timex-sinclair-projects/TS-2068-Megabank/README.md

# TS-2068 Megabank

A battery-backed 4 MB RAM board for the Timex Sinclair 2068, built the way
Timex meant memory to grow: as **expansion banks** that can take over any 8K
chunk of the address space. It is a card for the expansion bus, for owners
of the TS-Pico v3.

It gives the 2068:

- **Paged memory:** any 8K page of the 4 MB, mapped into any chunk with two
  `OUT`s, at full memory speed.
- **A RAM disk:** `SAVE "r:name"`, `LOAD "r:name"`, `CAT "r:"` and the rest,
  kept through power-off by a battery.

**Status:** design. Nothing is built yet. Start with the
[specification](docs/spec.md); the board's KiCad project (schematic done,
routed on the TS-Pico v3's form factor, DRC clean, not yet ordered) is in
[hardware/](hardware/README.md).

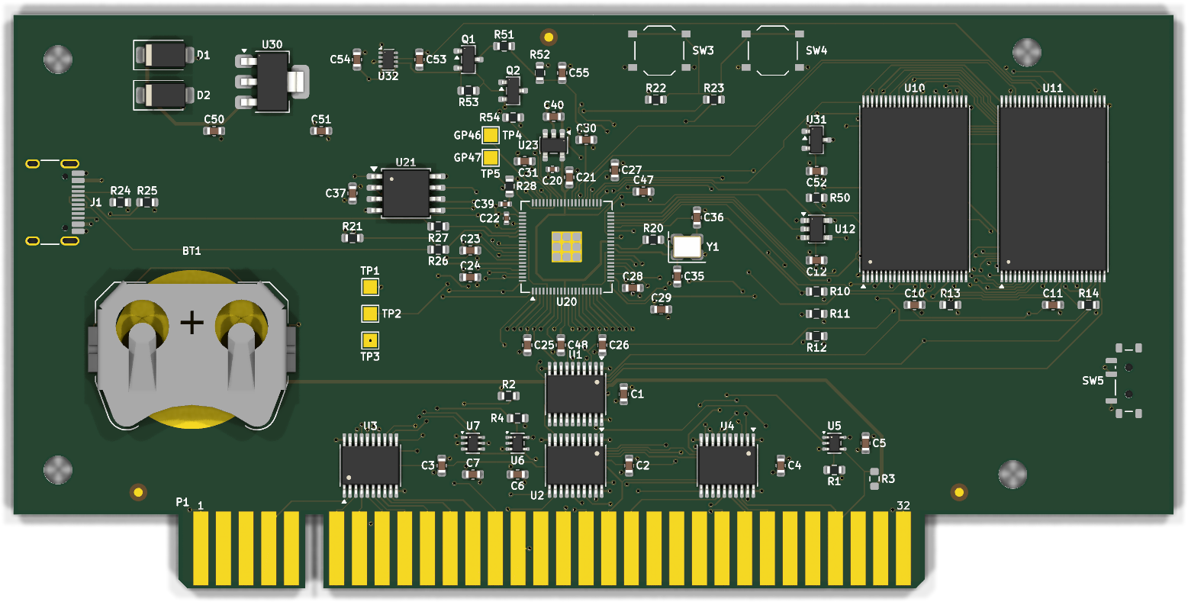
[picture p1: docs/images/megabank-top.png]
The Megabank card, rendered from the routed KiCad board: the RP2350B controller in the middle, the two 2 MB SRAMs on the right, the CR2032 battery on the left, the bus buffers over the gold fingers


*The routed card (KiCad render, 2026-11-07), the same 130 × 64 mm shape as
the TS-Pico v3. Underside: [docs/images/megabank-bottom.png](docs/images/megabank-bottom.png).*

## Where the work lives

| Part | Repository |
|---|---|
| The board: schematic, PCB, the controller's firmware | here |
| The TS-Pico ROM (detection, the RAM disk's copy routine, `r:`, the Timex bank API) and the v3 firmware (bus sharing, the RAM disk's file system) | [tspico-firmware-build](https://github.com/timex-sinclair-projects/tspico-firmware-build) |
| PicoVideo's support (ignoring screen writes to mapped banks) | [PicoVideo](https://github.com/timex-sinclair-projects/PicoVideo) |
| The emulator model | [zesarux-tspico](https://github.com/timex-sinclair-projects/zesarux-tspico) |

## The first test

Does a 2068 answer the board's ports, FCh and FDh? With nothing plugged in:

```
OUT 252,2: OUT 253,2: PRINT IN 252, IN 253
```

The border should not change, and nothing should answer either port.

**Result (2026-10-16), with the TS-Pico fitted:** the border did not change,
and both ports drift between 127 and 255 from one read to the next whatever
keys are held: a floating bus, with nothing answering. FCh and FDh stand.

## Licences

| What | Licence | File |
|---|---|---|
| Hardware design files: schematic and PCB | CERN Open Hardware Licence v2, Permissive (CERN-OHL-P-2.0) | [LICENSE-hardware.txt](LICENSE-hardware.txt) |
| Software: the board's controller firmware (RP2350B), tools and test programs | MIT | [LICENSE](LICENSE) |
| Documentation (`docs/`, this README) | Creative Commons Attribution 4.0 (CC BY 4.0) | [LICENSE-docs.txt](LICENSE-docs.txt) |
