timex-sinclair-projects/TS-2068-Megabank/docs/spec.md

# TS-2068 Megabank (specification, draft)

A battery-backed 4 MB RAM board for the 2068, built the way Timex meant
memory to grow: as **expansion banks** that take over any 8K chunk of the
address space, above HOME, EXROM and DOCK. It is a plain card for a free slot
on the expansion bus, for owners of the TS-Pico v3 card. It gives the 2068
two things it never had:

- **Paged memory.** A program maps any 8K page of the 4 MB into any chunk
  with two `OUT`s and uses it at full memory speed: fonts, icons, window
  buffers, code overlays, a second screen's worth of work space.
- **A RAM disk.** `SAVE "r:name"`, `LOAD "r:name"`, `CAT "r:"` and the rest,
  as fast as the Z80 can copy, kept through power-off by a battery. Later,
  `OPEN #` streams on its files: random-access records from BASIC.

It began with David's question (2026-10-16) whether the TS-Pico could emulate
the LarKen 256K RAMdisk, and with Jon, a 2068 GUI author, asking for a RAM disk.
Decisions taken with David on 2026-10-16 are marked **(decided)**.

**Paths** like `src/tsbus/tsbus.c` or `src/rom/TSPICO-23.ROM` are in the
TS-Pico firmware repository,
[tspico-firmware-build](https://github.com/timex-sinclair-projects/tspico-firmware-build),
where the ROM and v3 firmware changes will be made.

**Status (2026-10-16):** specification only. No hardware, firmware or ROM
change exists yet. Facts quoted from the 2068 ROM are from `src/rom/TSPICO-23.ROM`;
those still to be checked on hardware are listed under [Open questions](#open-questions).

## Contents

- [Background](#background): the LarKen RAMdisk, Timex's expansion banks, and
  why this design follows Timex
- [The board](#the-board): what it does on the bus
- [Registers](#registers): ports FCh/FDh
- [Programming it](#programming-it): for people writing 2068 software
- [ZXDesk](#zxdesk): Jon's port of a GUI desktop, and a storage backend
  for it on the board
- [Hardware](#hardware): the RP2350B controller, parts for JLCPCB
  assembly, battery backup, timing
- [Sharing the bus](#sharing-the-bus): the v3 card, PicoVideo, BUSISO
- [ROM](#rom): what ROM 2.4 adds
- [The RAM disk](#the-ram-disk): `r:`, the mover, the on-board format
- [Channels](#channels-phase-9): `OPEN #n,"r:name"`, streams and records
  on the RAM disk
- [Firmware](#firmware): the v3 card's part
- [PicoVideo](#picovideo)
- [Bus mastering (revision 2)](#bus-mastering-revision-2): what DMA
  into the 2068's RAM would take; not this board
- [Testing](#testing)
- [Phases](#phases)
- [Open questions](#open-questions)
- [Sources](#sources)

## Background

### The LarKen RAMdisk (1980s)

LarKen Electronics' RAMdisk was the 2068's best-known RAM expansion: up to
eight 32K static RAM chips with battery backup, for the LKDOS disk system.

- One chip at a time appears in the **upper 32K of the DOCK bank**: the chip is
  enabled when /MREQ and /ROSCS are low and A15 is high.
- `OUT 7,n` picks the chip. Bits 0–2 select it (in a scrambled order LKDOS
  undoes with a table: 7=A, 3=B, 5=C, 1=D, 6=E, 2=F, 4=G, 0=H), bit 6 enables
  writes. The port is write-only and decoded from A7–A3 = 0 only, so it
  answers all of 00h–07h.
- A 74LS175 latch holds the bits and is cleared at power-up (chip H,
  write-protected). A divider on the 2068's +15 V blocks writes while power
  comes and goes.

We first looked at emulating it on the TS-Pico itself (2026-10-16):

- **v2 can't:** its port decode sees only 0Eh/0Fh, and its dock SRAM is a chip
  the Pico can't read back.
- **v3 could do 128K:** four spare 32K lanes in its image SRAM, switched by
  patching one PIO instruction. But 256K needs the unfitted PSRAM, and the
  result still lives in the DOCK, where it collides with cartridge images
  and ZX48 mode.

A separate board with real battery-backed SRAM is better on every count
**(decided)**. LKDOS compatibility is dropped **(decided)**: this is for v3
owners.

### Timex's expansion banks

The 2068 was designed for far more memory than it shipped with. The Timex
*Third Party Software Guide* (TPSG, section 1) describes it:

- **256 banks of 64K**, each split into eight 8K **chunks** selected by
  A13–A15. Bank 255 is HOME, 254 is EXROM, 0 is DOCK, and **1–253 are
  expansion banks**, the banks Wes Brzozowski called "the missing 253".
- **Each chunk has exactly one owner at a time.** Expansion banks outrank
  DOCK and EXROM, which outrank HOME. HOME owns every chunk nobody else
  claims.
- **An expansion bank takes a chunk by pulling BE low**, which switches off
  all of the 2068's own memory (HOME, EXROM and DOCK selects) for that
  access, whatever ports F4h and FFh say.
- **The bus expansion unit's controller** was to hold, per bank, a
  4-bit-interface "horizontal select" register naming the chunks it owns.
  The TPSG puts its registers on ports FCh (data) and FDh (command). The
  ROM that shipped uses a different, memory-mapped scheme gated by the AY
  chip's IOA5 line (Brzozowski).
- **The ROM carries a bank API** for it: `BANK_ENABLE`, `GOTO_BANK`,
  `CALL_BANK`, `XFER_BYTES`, `GET_BANK_STATUS`, copied at boot from EXROM
  1000h–162Fh to RAM at 6200h (F9C0h in 64-column mode), plus a bank table
  (SYSCON) built by a boot-time search for banks.
- **None of it ever worked.** No bus expansion unit shipped, and Brzozowski
  (*Time Designs*, 1986–87) found the ROM code riddled with bugs: the boot
  search would crash a 2068 that had a real bank. His advice: keep the
  software model, fix the bugs, and replace only the two routines that touch
  hardware (`READ_BS_REG`, `WRITE_BS_REG`). William Pedersen (*Nite-Times
  News*, 1989) proposed the hardware shape used here: an 8-entry table of
  chunk owners, indexed by A13–A15.

### Why follow Timex

**The DOCK-based approach has a wall:** bit 7 of port FFh picks EXROM or DOCK
for every chunk at once. The TS-Pico ROM's own code runs from EXROM in chunks
0–1, so it could never see a DOCK-mapped RAM page at the same time. Expansion
banks sit above both and switch through BE, so:

- the ROM can map RAM into chunk 4 while running from EXROM;
- the DOCK stays free for the v3 card's cartridge images and ZX48 mode;
- the 2068's own documented bank API can be made to work, for the first time.

## The board

**Size: 4 MB (decided)**: 512 pages of 8K, presented as **64 expansion
banks** of 64K (banks 1–64 by default).

**The chunk owner table.** Because a chunk has one owner, the board needs no
register per bank, only one per chunk:

- `OWN0`–`OWN7`: the bank number that owns chunk 0–7, or 0 for none.
- `SUB0`–`SUB7`: which 8K of that bank appears there. Timex's model always
  shows chunk *n* of a bank in chunk *n*, so a write to `OWNn` sets `SUBn` to
  *n*. A program that writes a different `SUBn` afterwards can put **any page
  in any chunk (decided)**.

**On every memory cycle** the board looks up `OWN[A15:A13]`:

1. If the owner is one of the board's banks, and /MREQ is low and /RFSH is high,
   it pulls **/BE** low (open-drain).
2. A read (/RD low) drives D0–D7 from SRAM. An M1 opcode fetch is a read like
   any other, so code runs from the banks.
3. A write (/WR low) stores the byte, unless that chunk is write-protected
   (`WPROT`) or the write-protect switch is on. A refused write is dropped;
   /BE is still pulled, so it doesn't fall through to the 2068's RAM either.
4. Otherwise the board does nothing: no /BE, data bus untouched.

**The SRAM address** is `page × 8K + A12..A0`, with
`page = (owner − BASE) × 8 + SUB[chunk]` (0–511): 22 bits. With two 2 MB
chips the top bit picks the chip; with the four-chip fallback, the top two
([Hardware](#hardware)).

**Reset** (/RESET low): every `OWNn` = 0, `SUBn` = *n*, `WPROT` = 0. The
2068 boots as if the board weren't there. The SRAM keeps its contents.

**Bank numbers.** A setting in the controller's flash sets `BASE`, the first bank: 1, 65,
129 or 193. Two boards can share a 2068 (8 MB), and bank numbers stay inside
Timex's 1–253. With `BASE` = 193 only banks 193–253 (61) are usable.

## Registers

Two ports, decoded from A7–A0 only (A8–A15 ignored, like the v3 card), and
only in a real I/O cycle: /IORQ low with /RD or /WR low, **and /M1 high
(decided)**. An interrupt acknowledge is /M1 with /IORQ, and its address bus
holds the PC, so a decode on /IORQ and A7–A0 alone would take an interrupt at
an address ending FCh or FDh for a port access. Requiring /RD or /WR already
excludes it, as on the v3 card; /M1 is checked as well because it is free (it
is already on GPIO24) and keeps the rule true if the firmware ever acts on
/IORQ before the strobe. **FDh selects a register, FCh reads or writes it
(decided).** These are the
TPSG's BCMDPT and BDATPT. Taking FDh rules out emulating a Spectrum 128's AY
(FFFDh/BFFDh) on the v3 card later; David prefers later Yamaha sound chips
anyway **(decided)**.

| Reg | Name | R/W | Reset | Meaning |
|---|---|---|---|---|
| 00h–07h | `OWN0`–`OWN7` | R/W | 00h | Owner of chunk 0–7: an expansion bank 1–253, or 0 for none. 0, FEh and FFh all mean "none". A write also sets `SUBn` = *n*. |
| 08h–0Fh | `SUB0`–`SUB7` | R/W | *n* | Bits 0–2: the 8K of the owning bank that appears in chunk *n*. Bits 3–7 read 0. |
| 10h | `WPROT` | R/W | 00h | Bit *n* set: writes to chunk *n* are dropped while the board owns it. |
| 11h | `STATUS` | R | – | Bit 0: write-protect switch on. Bit 1: battery low. Other bits 0. |
| 12h | `ID` | R | – | A5h, the signature. |
| 13h | `IDCOMP` | R | – | 5Ah, its complement. With no board the bus floats: reads give 7Fh or FFh, never this pair. |
| 14h | `BASE` | R | – | The first bank number: 1, 65, 129 or 193. |
| 15h | `SIZE` | R | – | Banks fitted: 8, 16, 32 or 64 (a setting in the controller's flash, for boards built with fewer chips). |
| 16h | `VERSION` | R | – | Board/logic version, starting at 1. |

- **IN FDh** reads back the selected register number, so an interrupt handler
  can save and restore it.
- **No auto-increment**, so a device watching the bus (the v3 card, PicoVideo)
  follows the state from the writes alone: the last value written to FDh,
  then the value written to FCh.
- Unused register numbers read FFh and ignore writes.
- **Detecting the board:** `OUT (FDh),12h`, `IN A,(FCh)` gives A5h, then
  `OUT (FDh),13h`, `IN A,(FCh)` gives 5Ah. Anything else: no board. Never
  take a single FFh as "no board": the 2068's bus floats, and D7 often reads 0.

## Programming it

For people writing 2068 software, with or without the ROM's help.

**Map a page.** Put page 2 of bank 5 into chunk 4 (8000h–9FFFh):

```
        di
        ld   a,04h        ; OWN4
        out  (0FDh),a
        ld   a,5          ; bank 5; this also sets SUB4 = 4
        out  (0FCh),a
        ld   a,0Ch        ; SUB4
        out  (0FDh),a
        ld   a,2          ; page 2 of bank 5
        out  (0FCh),a
        ei
```

Unmap it by writing 0 to `OWN4`. For Timex-style use (chunk *n* of the bank in
chunk *n*), the first two `OUT`s are enough.

**Rules.**

- **Don't pull the floor out from under yourself.** Never map over the chunk
  holding the code that's running, or the stack, without moving them first.
- **Interrupts.** A register change is two `OUT`s. If an interrupt handler
  also uses the board, keep `DI` around the pair, or have the handler save
  `IN (FDh)` and restore it.
- **Chunks 0–1 hold the ROM** and the IM 1 handler at 0038h. Mapping RAM there
  is allowed (a 64K-RAM machine), but it is your job to have a handler at 0038h
  or to run with interrupts off or in IM 2.
- **Chunk 3 (or chunk 7 in 64-column mode)** holds the 2068's bank-switching
  code and the machine stack. Timex's rules reserve it. Map over it only if you
  know you don't need either.
- **The screen.** The SCLD draws the picture from its own 16K of RAM
  (4000h–7FFFh), whatever the Z80 sees there. Mapping a bank into chunk 2 or
  3 hides that RAM from the Z80, not from the display: the 2068 keeps showing
  it, and writes go to the bank. So a bank can never be the screen; a frame
  kept in a bank has to be copied into the SCLD's RAM to be seen. Whether
  Z80 accesses to a bank in chunk 2 or 3 are still contended is open
  question 19.
- **The RAM disk's banks** belong to the RAM disk ([below](#the-ram-disk)).
  Ask the ROM for pages rather than picking bank numbers yourself.

**Speed.** `LDIR` moves a byte in 21 T-states: about 160 KB a second at the
2068's 3.53 MHz. A 6K screen copies out of a bank in about 40 ms, **plus
contention**: the screen is in the SCLD's 16K (4000h–7FFFh), and every
access there goes through the SCLD, which stretches the Z80's clock while it
fetches the picture. Reads from the bank are uncontended; the writes into
the display file pay. Copy in the border and vertical blank where you can.
For whole-screen updates in the standard mode, copy into the screen not
being shown (4000h or 6000h) and flip with bit 0 of port FFh at the frame
interrupt, keeping its other bits (bit 7 is EXROM/DOCK, bit 6 the frame
interrupt disable): no tearing. ECM uses both halves, so it cannot flip.

## ZXDesk

ZXDesk is a windowed desktop for the Spectrum 48K by
[mindbox77](https://github.com/mindbox77/zxdesk): overlapping windows,
menus, a notepad, a clock, a calendar, settings and a two-pane file manager
(Commander). Jon, the GUI author behind the RAM disk request, has ported it
to the 2068: source at
[jon0x0/ts2068, ZXDesk2068](https://github.com/jon0x0/ts2068/tree/main/ZXDesk2068)
(read at `30c5d64`, 2026-10-29), with its README, roadmap and a TS-Pico
handoff. Its two builds are copied into [examples/](../examples/):

| Build | Loader | Screen | Code | Stack, IM 2 table | Files, buffers, heap |
|---|---|---|---|---|---|
| `zxdesk2068.tap` | `CLEAR 27647`, `RANDOMIZE USR 33280` | 256 × 192 | 6C00h–B542h | BD00h, BE00h | C000h–FEFFh |
| `zxdesk2068-512.tap` | `CLEAR 30719`, `RANDOMIZE USR 36352` | 512 × 192 | 7800h–C046h | C300h, C400h | C600h–FEFFh |

**How it runs.** It takes the machine over: all chunks HOME (F4h = 0),
its own IM 2 handler, no ROM calls, and no return to BASIC. It reads the
keyboard and both joysticks through the 2068's AY (Kempston mouse detection
is disabled in these builds) and beeps through FEh.

**How it stores files.** Through a registry of storage backends, each six
vectors (`StOpen`, `StClose`, `StRead`, `StWrite`, `StDir`, `StDelete`) plus
capability bits (write, persist, random access, directory). The 2068 build
registers one: RAM, four files of 256 bytes, lost at reset. The Spectrum
builds add tape, esxDOS, a printer, and **a Spectrum 128K RAM disk**
(`src/bank.inc`): a directory in one bank and eight files of 8K, paged in
at C000h through port 7FFDh and copied through a 256-byte staging buffer in
the code region.

**With the board fitted, today: no change.** The board starts with nothing
mapped and ZXDesk never touches FCh or FDh. One thing for Jon: the 2068
build still carries the Spectrum 128's AY routine, writing FFFDh and BFFDh.
The board decodes A7–A0 only, so both writes would land on FDh and change
the selected register (harmless: only a write to FCh changes the mapping).
The flag that selects that routine is cleared at start and never set on the
2068, so the beeper is used instead. Better to remove it than rely on that.

### A Megabank storage backend

The board's first use for ZXDesk: a backend, `ST_MEGABANK`, that keeps
files in battery-backed pages. It is the 128K backend with the paging
changed, and the board is a better fit for it than the 128K: an 8K page is
exactly one 128K file, and any page goes into any chunk with `OUT`s the
Z80 makes itself. (Jon's roadmap finds the TS-Pico's DOCK RAM harder to
use: one 64K bank at a time, each 8K only at its own address, and the bank
chosen by a firmware command whose timing is unmeasured.) The work is
Jon's:

1. **The layout.** Until `tpi:ram alloc` exists, use the board's first
   bank, pages 0–7 of the board: page 0 the directory, pages 1–7 seven
   files of 8K. The RAM disk grows down from the top of the board, so the
   bottom bank is the last it reaches. The directory page starts with a
   header: a magic number ("ZXDK"), a format version and the file count.
2. **A window in chunk 7.** For each directory access or transfer, map the
   page at E000h, copy through the staging buffer, and unmap, as the 128K
   backend does at C000h with 7FFDh. Chunk 7 holds only buffers and heap in
   both builds, never the code, the stack or the IM 2 table, and the
   interrupt handler touches nothing there. (Not chunk 6: in the 512-column
   build it holds the end of the code, the stack and the IM 2 table.) The
   rule reserving chunk 7 in 64-column mode
   ([Programming it](#programming-it)) protects the ROM's bank code and
   stack, which ZXDesk doesn't use. As with 7FFDh, a page can't be mapped
   while the caller's buffer is in the chunk it covers; the staging buffer
   is what makes that safe.

   ```
   ; Map page A (0-7) of the board's first bank at E000h.
   ; MbBase holds BASE, read once at start-up.
   MbPage:
           push bc
           ld   c,a
           ld   a,07h        ; OWN7
           out  (0FDh),a
           ld   a,(MbBase)   ; the first bank; this also sets SUB7 = 7
           out  (0FCh),a
           ld   a,0Fh        ; SUB7
           out  (0FDh),a
           ld   a,c          ; the page
           out  (0FCh),a
           pop  bc
           ret

   ; Give chunk 7 back to HOME.
   MbHome:
           ld   a,07h        ; OWN7
           out  (0FDh),a
           xor  a
           out  (0FCh),a
           ret
   ```

   ZXDesk's interrupt handler never touches the board, so the `OUT` pairs
   need no `DI`.
3. **Detect, then register.** At start, check `ID` (12h) for A5h and
   `IDCOMP` (13h) for 5Ah, read `BASE` (14h) into `MbBase`, and register
   the backend only if the board answers. With no board, ZXDesk is as it
   is now.
4. **Format only if the header is missing.** The 128K backend clears its
   directory at every start, since a 128K's RAM holds nothing worth
   keeping at power-on. Here the directory is the point: check the header
   and keep it if it is good. If not (a new board, or a reset in the
   middle of a directory write), ask before formatting.
5. **Read `STATUS` (11h) at start.** Bit 0 set: the write-protect switch is
   on, so register the backend without `STCAP_WRITE`. Bit 1 set: the
   battery is low; say so. Otherwise the capabilities are write, persist
   and directory, with delete.

Larger files need more than pages: the notepad, Commander's copy (one
256-byte chunk today) and the file lists have their own limits, which
Jon's roadmap already plans to lift.

**Testing.** In the emulator model
([zesarux-tspico](https://github.com/timex-sinclair-projects/zesarux-tspico)):
save a note, reset, load ZXDesk again and open it; with the switch on, a
save is refused and the file is unchanged. Jon's automated test runs on his
TSRun emulator, which would need the board's registers and pages modelled.
On the board, the same across a power cycle.

**Later.** More files than one bank holds (pages from `tpi:ram alloc`);
window save-areas and other buffers in pages, which the 512-column build
most needs, having about 6.4K of heap to the 256-column build's 7.9K (Jon's
roadmap puts a RAM disk first); and files exchanged with BASIC as `r:`
files, which needs a machine-code entry to the RAM disk because ZXDesk
doesn't use the ROM (open question 8).

## Hardware

**Built by JLCPCB, surface-mount throughout (decided).** The board is made the
way the v3 card is, and reuses its tools from the
[tspico-hardware](https://github.com/factus10/tspico-hardware) repository:
`scripts/parts.py` (MPN and LCSC number for every part), `scripts/jlc_price.py`
(prices and stock against JLCPCB's catalog) and `scripts/gen_fab.py` (the
upload files). The aim is no hand soldering. The RP2350's core-regulator
inductor, the one part that might have needed it, is gone: an LDO supplies the
core instead ([Parts](#parts)). The CR2032 holder is the Keystone part that
JLCPCB placed on the OpenSpand card; another holder pushed the order to its
Standard PCBA.

**Design flow (decided): v3's script pipeline**, in tspico-hardware's
`hardware/scripts/`, adapted (it hardcodes the name `tspico-v3`, the board
size, the placement table, the plane nets and the pre-routes):

- **Schematic** from Python with `schlib.py`: every pin gets a net label, no
  wires; one `gen_<sheet>.py` per sheet, flat hierarchy with global labels;
  `parts.py` stamps MPN and LCSC fields. The root sheet is written by hand
  first. KiCad 10.
- **Board** rebuilt from scratch each time: `gen_board.py` (outline, the
  JLC04161H-7628 4-layer stackup, holes, fiducials), then `gen_layout.py`
  (netlist via `kicad-cli sch export netlist`, footprints and a placement
  table in code, GND and +3V3 planes on the inner layers).
- **Routing**: `flow.py --jar freerouting-2.4.1.jar` runs placement,
  `preroute.py` (locked hand routes: the RP2350B's regulator pins and core
  supply, crystal and QFN fanout), `autoroute.py` (plane fanout vias, DSN export, Freerouting, SES
  import) and `finish.py` (repairs, DRC), retrying from placement up to three
  times; then `silk.py`. `check.sh` runs ERC and DRC; `gen_fab.py` writes the
  JLCPCB files. Rules: 0.6/0.3 mm vias, 0.127 mm clearance, no tracks on the
  plane layers. Copying v3's RP2350B placement and orientation lets its
  pre-routes carry over.

**3.3 V inside, 5 V bus (decided).** A controller (RP2350B) and 3.3 V SRAM sit
behind 74LVC buffers. LVC inputs accept the 2068's 5 V, and a 3.3 V high is a
valid TTL high for the Z80, as the v3 card already shows. These are v3's parts
and toolchain. There is no CPLD and no WinCUPL.

### The controller

**An RP2350B replaces the CPLD (decided), as the memory map, not the data
path.** It decodes FCh/FDh, holds the registers, and for each memory cycle
gives /BE, the page's address bits and the SRAM enables. The bytes go straight
between the SRAM and the bus through a 74LVC245, so the RP2350B never handles
them in a memory cycle. Being software, it can grow: a write fence (open
question 4), new registers, settings, all through a firmware update.

- **/BE** uses the mechanism the v3 card proved on a 2068 (`serve` in
  `src/tsbus/tsbus.pio`). A PIO program reads A15–A13 and jumps (`out pc, 3`)
  through an 8-entry chunk table that core 1 patches whenever a register
  changes, with /BE side-set on the same instruction, at 250 MHz. Here the
  table is the owner table: a chunk owned by one of the board's banks jumps to
  the path that asserts /BE.
- **The page bits are not time-critical.** On a 3.53 MHz read about 400 ns pass
  between a valid address and the data being needed; the SRAM (45–55 ns) and a
  buffer (about 5 ns) use under 70 of them. Whether the page comes from a second
  PIO table, a DMA-chained lookup or core 1 is settled on the bench (open
  question 2).
- **Register writes** are I/O cycles of over a microsecond. A PIO program
  catches `OUT` to FDh/FCh, as v3's `io_snoop` does (v3 waits on a gated
  /IOWR; here /IORQ, /WR and /M1 arrive separately and the program checks all
  three, [Registers](#registers)), and core 1 updates the
  tables before the next memory read. `IN` from FCh/FDh is answered the way v3's
  `io_drive` answers `IN 0Eh`.
- **Settings** that were switches and jumpers (`BASE`, `SIZE`) live in the
  controller's flash (open question 11).
- **Safe at power-up.** Every controller output that enables something is
  inactive in the RP2350's reset state (external pull-ups, or an inverting
  driver like /BE's), so the board stays off the bus until its firmware runs.
  The ROM's boot-time writes then set it up ([Sharing the bus](#sharing-the-bus)).

**Pins.** The RP2350B has 48 GPIOs; the 30-GPIO RP2350A is too small.

| Signals | Pins |
|---|---|
| A0–A7 (port decode) and A13–A15 (chunk), from the address buffers | 11 |
| D0–D7, on the SRAM side of the data buffer | 8 |
| /MREQ, /IORQ, /RD, /WR, /RFSH, /M1, /RESET, from the control buffer | 7 |
| /BE request | 1 |
| Page bits: 8 to SRAM A13–A20 (the 9th picks the chip, through the /CE1s) | 8 |
| /CE1 of each SRAM, write inhibit, data buffer enable | 4 |
| Write-protect switch | 1 |
| Battery: ADC (GPIO40–47) and BAT_EN | 2 |
| /BE read back, through the control buffer's spare channel | 1 |
| /INT and /NMI in, through a 74LVC2G34; /NMI out, open-drain (open question 16) | 3 |
| **Total** | **46 of 48** |

The data buffer's direction comes from the buffered /RD, not from a pin. The
two spare GPIOs, 46 and 47, go to test pads TP4 and TP5 (silk "GP46",
"GP47"), for bench experiments such as a second controller's handshake
([Bus mastering](#bus-mastering-revision-2)).

### Parts

Candidates, with JLCPCB stock on 2026-10-16. Availability is open question 6.

| Function | Part (candidate) | LCSC | Notes |
|---|---|---|---|
| Memory | 2 × CY62167EV30LL-45ZXIT (16 Mbit, 2.2–3.6 V, 45 ns, TSOP-I 48), used as 2M×8 | C511152 | 4 MB in two chips. **×8 confirmed (decided):** BYTE tied to ground makes it 2M×8, pin 45 (I/O15/A20) becomes A20, and BHE, BLE and I/O8–I/O14 are unused. Preferred over the DV30 for its standby current (below). 42 in stock: thin. |
| Memory (alternate) | 2 × CY62167DV30LL-55ZXIT (same package drawing 51-85183 and pinout) | C2956479 | 168 in stock. The same footprint, with one difference: the DV30 marks BHE and BLE "do not use, leave floating", while the EV30 needs them tied to a logic level for its standby figures. Route each to ground through an unfitted 0 Ω pad: fitted for the EV30, left open for the DV30. Its standby is worse: 22 µA maximum per chip, with every input within 0.2 V of a rail. |
| Memory (fallback) | 4 × IS62WV51216BLL-55TLI (512K×16, 3.3 V, TSOP-II-44) | C11315 | 3,623 in stock. Used as ×8: D0–7 tied to D8–15, /LB from A0 and /UB from A0 through a 74LVC1G04; A1–A12 and the page bits form the word address. A different footprint: choose before layout. **No CS2 in TSOP-II (confirmed):** its only chip select is CS1 (pin 6); CS2 exists only on the 48-ball mini-BGA, and JLCPCB's only BGA in stock is the 1.8 V IS62WV51216ALL. So power-fail protection goes through /LB and /UB instead: both come from gates on the SRAM rail whose other input is a "power not good" line (pulled up to the SRAM rail, pulled low by an N-MOSFET from the supervisor while 3.3 V is good), and a chip with both high is deselected. Four chip selects: 44 of the RP2350B's 48 pins. **Much worse standby:** 4 µA typical but 25 µA maximum per chip (industrial), and 20 µA maximum in data retention (down to 1.2 V), with every input within 0.2 V of a rail. Four chips could draw about 100 µA: about three months on a CR2032, nine on a CR2450. Order of preference: EV30, DV30, then this. |
| Controller | RP2350B (QFN-80), with v3's core circuit (QSPI flash, crystal) and an LDO for the core | C42415655 | 4,873 in stock. Copy v3's RP2350B schematic sheet, but **supply DVDD from a 1.2 V LDO (decided 2026-11-07)**, an ME6211C12M5G-N (SOT-23-5, C236672), as on the [OpenSpand card](https://github.com/timex-sinclair-projects/openspand-smd) (U9), instead of the on-chip switching regulator. The switcher's inductor, L1 on v3 (Abracon AOTA-B201610S3R3-101-T, C42411119), was the scarcest part on the board (4 at JLCPCB on 2026-10-16, 3 in October), the only one approved for the RP235x, and would have needed JLCPCB's pre-order or Global Sourcing, or hand fitting. Per the RP2350 datasheet, section 6.3.7, VREG_LX is left open and VREG_FB goes to ground, while VREG_VIN and VREG_AVDD stay powered (the power-on reset runs from them). A fixed 1.2 V matches v3's firmware, which runs at 250 MHz after `vreg_set_voltage(VREG_VOLTAGE_1_20)` (`src/tsbus/tsbus.c`, tspico-firmware-build); here that call has nothing to do, and the firmware may put the unused regulator in its high-impedance mode to save about 400 µA. The LDO is less efficient (3.3 V in, 1.2 V out: about a third of its input power reaches the core), a few tens of milliwatts on a card powered from the 2068. |
| Buffers | 4 × 74LVC245APW: A0–A7, A8–A15 and the control lines one way; D0–D7 both ways | C6082 | The same part as v3. Their power-off protection (Ioff) means that with the 2068 off they neither drive nor load the SRAM side. |
| /BE driver | 74LVC1G06 (inverting, open-drain) | C7828 | Wire-ORs with v3's 74LVC06. The RP2350's reset state (input, pull-down) leaves /BE released. |
| /NMI driver | 74LVC1G06, a second one | C7828 | The same part, so no second loading fee. Wire-ORs with v3's driver and NMI button; a 10 k pull-down holds it released until the firmware runs, as for /BE. |
| /INT, /NMI in | SN74LVC2G34DCKR (dual buffer, SC-70-6, TI), on 3.3 V | C14461 | 21,890 in stock on 2026-10-19. 5 V-tolerant inputs, as the 74LVC245s. |
| Chip enables | The CY62167's two: /CE1 (active low) and CE2 (active high) | | CE2 low deselects the chip whatever /CE1 does, including in data retention. **Both chips' CE2 come from the supervisor**, with a pull-down to ground, so they are high only while 3.3 V is good. **Each chip's /CE1 comes straight from the controller**, qualified by /MREQ, with a pull-down so it sits at a logic level on battery. No decoder, and no logic on the SRAM rail. |
| /WE gate | SN74LVC1G32DBVR (OR, SOT-23-5, TI), on 3.3 V | C10096 | 139,210 in stock on 2026-10-16. SRAM /WE = buffered /WR OR the controller's write inhibit, which it sets per chunk from `WPROT` and the switch. The write-inhibit line has a **pull-up**, so writes are blocked until the controller's firmware runs: Z80 writes during its boot cannot reach the RAM disk. |
| Power mux | LM66200 (ideal-diode ORing, 1.6–5.5 V, 1.32 µA) | C3235556 | Feeds the SRAM rail from 3.3 V or the battery. **Not the TPS2115A:** it draws about 55 µA from the battery, which would empty a coin cell in months. **Not plain diodes:** with 3.3 V on, the SRAM rail must stay close to 3.3 V, or the buffers and the controller push current into the SRAM's input clamps. |
| Supervisor | TPS3839G33 on 3.3 V (threshold about 3.08 V) | C485802 | Drives both chips' CE2 directly: high while 3.3 V is good, low below the threshold, and the pull-down holds them low with 3.3 V gone. So no writes happen while power rises or falls, well above the SRAM's 2.2 V minimum. Push-pull output, so CE2 needs no pull-up; its output is undefined below 0.6 V, which is what the pull-down covers. Its 200 ms delay keeps the SRAM deselected for 200 ms after power-on: harmless, since nothing maps a bank until software writes the registers. |
| Battery | CR2032 in an SMD holder (a CR2450 clip for longer life) | C22363833, C7498149 | **Keystone 3034TR, C5213768 (decided 2026-11-07),** as on the OpenSpand card, where JLCPCB placed it; 654 in stock. The Q&J CR2032-BS-6-1 (C70377) made JLCPCB move the order to Standard PCBA. If stock runs out, leave it off and fit a 3034 from DigiKey (36-3034-ND) by hand. Two CY62167EV30s in standby (1.5 µA typical, 3.0 µA maximum at 25 °C and 3.5 µA at 40 °C, each) plus the mux (1.3 µA): about 8.5 µA worst case at room temperature, so about three years on a CR2032 and eight on a CR2450. At 85 °C the chips' maximum is 12 µA each. Data is kept down to 1.5 V. Measure the real board. |
| Battery monitor | The RP2350B's ADC, through a switched divider | | [Battery monitor](#battery-monitor). `STATUS` bit 1 below 2.5 V. |
| Switch | Write-protect, SMD slide | | |
| Pull resistors | 6 × 10 k, 0603 (0603WAF1002T5E) | C25804 | JLCPCB basic part, as on v3: no loading fee. **To ground:** CE2 (one, for both chips), each chip's /CE1 (two), the /BE request into the 74LVC1G06 (one, so boot does not rely on the RP2350's internal pull-down and its E9 erratum). **To 3.3 V:** write inhibit (one), the data buffer's /OE (one). 10 k on CE2, not 100 k: CE2 must stay under 0.2 V on battery, and two chips' input leakage (up to about 1 µA each) would put 0.2 V across 100 k; with 3.3 V on, the supervisor still gives at least 2.9 V into it (VDD − 0.4 V at 0.5 mA). The /CE1s are pulled *down*: a pull-up to the SRAM rail would feed the unpowered RP2350B. |
| BHE/BLE links | 2 × 0 Ω, 0603 (0603WAF0000T5E) | C21189 | JLCPCB basic. BHE and BLE to ground: fitted for the EV30, do-not-place for a DV30 build. |

**Standby with the controller off.** CE2 is held low by its pull-down, so the
chips are deselected. The EV30 datasheet allows the other inputs (address, data,
/OE, /WE) to float in standby; only CE1, CE2, BHE, BLE and BYTE must sit at
logic levels, which the pull-downs and the ties to ground give. (The DV30
specifies standby with every input at a rail.)

**From the EV30 datasheet, for layout:** in TSOP-I, input low must not exceed
0.7 V while signals switch (0.8 V static), so keep ground bounce down; and
the chip wants a 100 µs supply ramp and 200 µs before full operation, which
the RP2350B's boot more than covers.

### Battery monitor

The coin cell is measured straight off its terminal, before the LM66200,
through a switch that is off whenever the controller is unpowered or booting,
so the battery never feeds the RP2350B's ADC pin. All parts are JLCPCB basic.

| Net | Connects |
|---|---|
| BATT+ | Battery +, LM66200 IN2, Q1 source, R3 |
| Q1 gate | Q1 gate, R3, Q2 drain |
| Divider top | Q1 drain, R1 |
| ADC | R1, R2, C1, RP2350B ADC pin (one of GPIO40–47) |
| BAT_EN | RP2350B GPIO, Q2 gate, R4 |
| GND | Q2 source, R2, C1, R4 |

| Ref | Part | LCSC | Notes |
|---|---|---|---|
| Q1 | AO3401A, P-channel, SOT-23 | C15127 | Source to the battery. Turns on at about 0.9 V gate drive, so it works down to a 2.0 V cell. Its body diode points at the battery and never conducts, since the drain side is never above it. |
| Q2 | AO3400A, N-channel, SOT-23 | C20917 | Pulls Q1's gate to ground when BAT_EN is high. Threshold at most 1.45 V: margin on a 3.3 V GPIO. |
| R1, R2 | 100 k, 0603 | C25803 | Halves the cell (2.0–3.3 V) to 1.0–1.65 V, clear of the ADC's 3.3 V full scale. 16 µA only while measuring. R2 also holds the ADC pin at 0 V when off. |
| R3 | 1 M, 0603 | C22935 | Holds Q1's gate at the battery: off. |
| R4 | 10 k, 0603 | C25804 | Holds BAT_EN low while the controller is unpowered or booting. The same part as the other pull resistors. |
| C1 | 100 nF, 0603 X7R | C14663 | A low-impedance source for the ADC's sampling capacitor. |

**Off,** the battery's only load here is the two MOSFETs' leakage, well under
a microamp. **To measure,** the controller drives BAT_EN high, waits 25 ms (the
divider and C1 settle with a 5 ms time constant, 50 k × 100 nF), averages a
few ADC readings, and drives BAT_EN low again: battery = 2 × reading ×
3.3 V / 4096. It sets `STATUS` bit 1 below 2.5 V, at boot and perhaps hourly
after. While 3.3 V is present the LM66200 runs from it, so the reading is the
idle cell; a lithium coin cell holds near 3.0 V most of its life and falls
near the end, so 2.5 V is a late warning, not an early one.

### Timing

The 2068's memory cycles leave about 300–400 ns from address to data; 45–55 ns
SRAM through a 5 ns buffer fits with room to spare. The critical path is
**/BE**: it has to switch off the 2068's own memory before that memory drives
the bus. The v3 card does exactly this from the same RP2350 PIO path, and it
works on a 2068. The board's version must still be measured on a 2068 through
the expansion bus, with the v3 card in place (open question 2).

**Refresh.** On a refresh cycle (/RFSH low) the controller stays off the bus
and leaves /BE alone, so it never interferes with the 2068's DRAM refresh.

### Form factor

A standard card for the expansion bus card (TS2068_Extender): three slots and a
pass-through, of which the TS-Pico and PicoVideo normally take two. The board
needs no pass-through of its own. **Gold fingers on the PCB edge (decided)**, using v3's footprint
`TS2068_EdgeConnector_2x32` (generated by `gen_board.py`, measured from the
v2.2 Gerbers): 32 positions at 2.54 mm, 31 fingers a side, the key slot at
position 6, an 83.66 × 8.25 mm tongue with 1 mm corner chamfers; pinout from
the TS2068 Technical Manual (table 2.4.1-1). Order with hard gold if offered
(else ENIG), a 30° bevel, and no copper within 0.3 mm of the slot. v3's
assumption that side A is the top is still unverified: check it before
ordering. **The body is v3's too (2026-10-18):** 130 × 56 mm with the
tongue below, v3's four M3 holes, the RP2350B cluster at v3's coordinates so
its pre-routes carry over. The firmware loads over USB-C, as on v3, with SWD
pads as well (open question 11). The KiCad project, its generators, the GPIO
map and the placement are in [`hardware/`](../hardware/README.md).

## Sharing the bus

Three cards may answer memory cycles: the 2068 itself, the v3 card (HOME and
EXROM with /BE, DOCK without), and this board. Only one answers any access,
and none of it depends on BUSISO or IOA5:

- **The board answers only chunks whose owner is one of its banks.**
- **The v3 card watches the FDh/FCh writes** and stops serving any chunk whose
  owner is 1–253 ([Firmware](#firmware)). Without that, a DOCK chunk would
  have two drivers: /BE switches off the 2068's memory but not the v3 card.
- **/BE is open-drain on both cards**, so they never fight electrically.
- **PicoVideo watches the same writes** and stops copying screen writes into
  its display when chunk 2 or 3 is owned by a bank ([PicoVideo](#picovideo)).
- **The ROM writes every `OWNn` = 0 at boot**, even though the board clears
  them on reset. PicoVideo can't see /RESET and the v3 card keeps its
  shadows through a plain reset, so the boot-time writes resynchronise every
  device that watches.

**BUSISO is not used.** On the TS2068_Extender, a per-slot jumper feeds /BE
to the BUSISO pin of the next-lower slot, so a device there can hold off its
own /BE. The TS-Pico goes in slot 1 with its jumper open (closed, it sees
its own /BE and stops working). This board goes in any free slot, jumper
open, and arbitrates through the owner table instead.

**IOA5 is not used.** It is free on the bus, and the shipped ROM's bank
protocol gated register writes with it. But it is a pin of the AY's port A,
whose direction is bit 6 of AY register 7, the register that also mixes the
tone and noise channels. Sound code commonly writes all of R7, so it would
flip IOA5 under the board's feet; port A also carries the joysticks. Ports
FCh/FDh do the job without that hazard **(decided)**.

## ROM

ROM 2.4 is ROM 2.3 plus patches, built the usual way: `tools/build-rom.py`
byte patches that state the bytes they replace, and new code in the module.
Addresses below are EXROM addresses (X) and, for the bank code that runs from
RAM, the RAM address (RAM = X + 5200h; in 64-column mode the code runs 97C0h
higher). All were read from `src/rom/TSPICO-23.ROM` and compared with the
genuine EXROM (`ROMs/GENUINE-2068-exrom.bin`, the same as ZEsarUX's).

### What ROM 2.3 does with the board

**Nothing, safely.** The boot still runs Timex's bank search (X0A3E–X0DAF). It
probes for banks through the memory-mapped, IOA5-gated registers. A board that
answers only ports FCh/FDh reads as absent, so the bank count stays 0:
`MAXBNK` (5CBEh) and the copy every bank routine reads, at 6315h. Every bank
routine then takes its fast path. A board on a 2068 with ROM 2.3 is invisible
until software writes its registers directly.

**Why the bank count must stay 0 until the bank code is rewritten.** Every
`tpi:` command crosses between HOME and EXROM through `CALL_BANK` and
`GOTO_BANK`, and so does every interrupt that arrives while the EXROM is
mapped (the handler at 62AEh). With a nonzero count:

- each crossing loops over every bank in `SAVE_STATUS`, `BANK_ENABLE` and
  `RESTORE_STATUS`, through the slow memory-mapped register routines (an
  estimated 45 ms per crossing with 64 banks);
- every call that asks for all chunks as HOME (`FF00`, which the TS-Pico's own
  crossings use) first takes every chunk from every expansion bank, so a
  program's mapped pages would vanish behind each ROM call.

So the minimal ROM leaves the count at 0, and the Timex API doesn't know the
board exists. The RAM disk and programs use the registers directly.

### What the ROM needs from SYSCON

SYSCON (5CBCh) points to a table at 5EEAh: the AROS header (8 bytes), the
LROS header at +8 (4 bytes), then 24-byte bank entries from +0Ch, ended by
80h. The boot builds it (EXTINIT X08E7, BLDSCT X09F4) and reads it to start
a cartridge. After the boot, almost every read sits behind a cartridge or a
banked channel:

- **AROS BASIC** (GETAL, AR_LN, AR_NXT, READ, and CLEAR and RUN resetting
  DATADD) tests `ARSFLG` bit 7 first.
- **SELECT** (1265h) and **CLCHAN** (13D8h) read it only for a stream offset
  with bit 7 set ([What `f:` already settled](#what-f-already-settled)).
- **SRCHSC** (1374h) has two callers, the banked OPEN at 1488h and `SAVE *`
  at 24EEh, and nothing reaches either.
- **The bank API** never reads it.

Three reads don't wait for a cartridge. They test SYSCON+1 for 02 (an AROS)
on every 2068:

- **FOR** (1CD1h), when the loop runs zero times and searches for its NEXT;
- **RESTORE** (1EA0h), every time;
- **USR** (388Eh), every call. If SYSCON+1 is 02 and the address is 8000h or
  more, it maps the DOCK chunks named at SYSCON+4 before the call.

These HOME addresses are the same in the genuine ROM and the TS-Pico's. So
for the whole session, not only at boot:

- SYSCON stays 5EEAh, and SYSCON+1 stays 00 unless an AROS is fitted. A
  stray 02 at 5EEBh would make every RESTORE and USR page the DOCK in.
- Nothing of ours (the module, the mover, RAM disk buffers) goes in
  5EEAh–5FFFh. Open question 17 asks whether the TS-Pico plans to.

### Minimal ROM: detection, reset, mover, `r:` (phase 4)

1. **Replace the bank search.** A `JP` at X0A3E to new code frees the old
   search's body, X0A3E–X0DAF: 882 bytes in EXROM chunk 0, which today has
   about 84 bytes free. It is entered two ways, both landing at X0A3E: `CALL 0A3E`
   at X1CA8 (the boot path taken when D is held at power-on, undocumented
   until now) and the fall-through from X09F4, which reads the DOCK's
   LROS/AROS headers on the normal path. The block X0C4C–X0CFA is reachable only
   from HOME 2487h, which nothing calls. (To verify when patching: no other
   entry into the range.) The new code:
   - writes `OWN0`–`OWN7` = 0 and `WPROT` = 0, so every device watching the bus
     starts in step;
   - checks `ID`/`IDCOMP`, reads `BASE`, `SIZE` and `STATUS`;
   - reports them to the TS-Pico (how: open question 3);
   - leaves `MAXBNK` and 6315h at 0;
   - ends as the old code did: `CALL 2082h` (writes SYSCON's 80h end marker).
     The old code also called the renumbering at X0CFB, which does nothing with
     no banks; keep or drop it once checked.
2. **The mover** ([The RAM disk](#the-ram-disk)): the operation loop, the
   window choice and the copy loops, in EXROM chunk 1's free space
   (23D4h–2FFFh, 3116 bytes, and 37B5h–3FFFh, 2123 bytes). Estimated under 512
   bytes.
3. **The `r:` prefix**: a test in `F_HOOK` (`fddcmd.asm` 585) beside the
   `f:` one, a new TPMODE bit (bits 7 and 6 are `tpi:` and `net:`), and the
   tape block routines calling the mover when it is set. `CAT`, `ERASE`,
   `MOVE` and `FORMAT` already reach the firmware as `tpi:` strings, so `r:`
   names need firmware work only.

### The Timex bank API on the board (phase 8)

The owner table makes this much cheaper than Timex's design: the state the
API loops over, one register set per bank, is just 16 bytes on this board
(`OWN0`–`OWN7`, `SUB0`–`SUB7`), whatever the bank count.

1. **Rewrite `WRITE_BS_REG` and `READ_BS_REG`** (RAM 635Ch–6404h, X115C–X1204,
   169 bytes, contiguous) as a translation onto the ports. Keep both entry
   points: their callers and the 64-column fixups (X1D2A, 2C, 2E, 36) use them.
   - A BNA write (register 80h) goes to a RAM latch.
   - An HS write (40h) for bank *b*: `OWNn` = *b* for each bit set; `OWNn` = 0
     where `OWNn` was *b* and the bit is clear.
   - A universal deselect (A0h with BNA 0): `OWNn` = 0 for each bit set.
   - A status read: present (bit 2 = 0) if *b* is within `BASE`…`BASE+SIZE−1`.
   - This also removes a bug: today's `READ_BS_REG` copies the screen byte at
     4000h into 8000h on its way out.
2. **Rewrite `SAVE_STATUS` and `RESTORE_STATUS`** (651Eh/654Ah) to save F4h,
   FFh and the 16 board bytes: constant time instead of a loop per bank.
   `CALL_BANK` reserves (bank count + 2) bytes per frame for this; that size
   changes to match. `RESTORE_STATUS` writes FFh before F4h, which briefly
   maps the DOCK: keep it under `DI`, as the TS-Pico's crossings already are.
3. **Only then** set `MAXBNK` and 6315h to the bank count.
4. **Narrow the TS-Pico's own crossings** from "all chunks to HOME" (`FF00`)
   to chunks 0–1 (`FFFC`, the mask is active-low), so a program's pages in
   chunks 2–7 survive ROM calls. Check each: HOME 3CE3h and 0A50h, HOME 03FCh
   (through 040Dh), EXROM 03DDh, 08DDh, the error path at 0017h–002Dh, and the
   interrupt handler at 62AEh.
5. **Fix the 64-column relocation table.** Four of its 61 entries are wrong
   (X1D34: 64ACh should be 64A9h; X1D38: 650Eh → 650Fh; X1D3A: 6516h → 6517h;
   X1D68: 674Fh → 6744h). In 64-column mode they break `BANK_ENABLE`'s
   expansion-bank paths and all of `XFER_BYTES`. Harmless today, because the
   count is 0. A patch to the EXROM image reaches both copies, since the high one
   is copied from the low.
6. **Brzozowski's patches.** All ten sites still hold the genuine bytes in ROM
   2.3, so every bug is present:

   | RAM | X | Now | New | Fixes |
   |---|---|---|---|---|
   | 649A | 129A | C5 | F3 (DI) | `BANK_ENABLE` not atomic |
   | 651B | 131B | C1 | FB (EI) | same |
   | 66DF | 14DF | 75 | 73 | `MOVE_BYTES` stores HL instead of DE |
   | 66E2 | 14E2 | 74 | 72 | same |
   | 66F3–66F5 | 14F3 | 07 0F 38 | 0B 3C 28 | `CREATE_BITMAP` end byte |
   | 6722 | 1522 | F5 | 00 | `XFER_BYTES`: drop `PUSH AF` |
   | 672B | 152B | 0A | 08 | its parameter offset |
   | 676A | 156A | 47 | 5F | `XFER_BYTES` same-bank mask |
   | 67C2 | 15C2 | 2B | 2C | keep A = 01 on abort |
   | 67FF | 15FF | F1 | 00 | drop `POP AF`; A returns 00 done, 01 aborted |

   Two cautions. His `EI` is unconditional, which would re-enable interrupts
   inside the TS-Pico's own `DI` sections: restore the previous state instead
   (`LD A,I` gives it in P/V). And the `XFER_BYTES` patches change A on return;
   the old bank search relied on it, but the minimal ROM removes that code, and
   the remaining callers (HOME 1899h, 1E0Dh) don't use A.
7. **For the whole API**, also: `GET_STATUS` returns the mask in C for
   expansion banks but in B for the others; `GET_NUMBER` is broken once banks
   exist (its `DJNZ` count is overwritten by `GET_STATUS`, and its EXROM test is
   unreachable); `PUT_WORD`'s `LD D,B` destroys D before storing it; Timex
   Technical Manual fixes 6.5.2–6.5.6.

Items 1–5 make `BANK_ENABLE`, `GOTO_BANK`, `CALL_BANK` and `XFER_BYTES` work
with the board; 6 and 7 complete the API. Which of these to do is open
question 5.

**Two reference gaps** found on the way, for the programmer's reference
whatever happens to this plan: the TS-Pico ROM changes `CALL_BANK` at X1410
(`LD B,(IX+08h)` → `LD B,(IX+09h)`, apparently a fix: the genuine code read
PARAM_IN's low byte twice), and the boot's D-key path at X1C86, which skips the
DOCK header read. Neither is in `docs/reference/rom/`.

## The RAM disk

**The split: the v3 card keeps the file system, the Z80 moves the bytes.**
The TS-Pico can't reach the board's memory, but the Z80 can, at `LDIR`
speed. So:

- **The firmware** (Python, on the v3 card) owns the directory, allocation,
  names, `CAT` output and errors. It is written and host-tested like the rest
  of the firmware, and costs no ROM space.
- **The ROM** runs a small loop, the **mover**, that does what the firmware
  tells it, one operation at a time, over the existing port 0Eh link.
- **The file system's data lives on the board**, so it survives power-off
  with the files. The firmware holds only a cache.

### The mover's operations

The firmware sends an operation; the ROM does it and replies with a status
byte. All lengths are 1–65535; "page:offset" is an 8K page (0–511) and an
offset into it, and a transfer may cross pages.

| Op | Does | Used by |
|---|---|---|
| 1 | Copy *len* bytes of 2068 memory at *addr* to page:offset | SAVE |
| 2 | Copy page:offset to 2068 memory at *addr* | LOAD, MERGE |
| 3 | Compare page:offset with 2068 memory at *addr*; reply with the result | VERIFY |
| 4 | Send page:offset to the TS-Pico through port 0Eh | reading the directory; MOVE from `r:`; backup |
| 5 | Receive bytes from the TS-Pico into page:offset | writing the directory; MOVE to `r:`; restore |
| 6 | Copy page:offset to page:offset (both on the board) | compaction |
| 0 | Done; carries the report code to end the command with (0 = OK) | every command |

**How the mover maps a page.** For each piece of a transfer that lies in one
8K chunk of 2068 memory, it picks a **window chunk** from 4–7 that holds
neither that piece nor the stack. With four candidates and at most two
excluded, one is always free. Then, with interrupts off:

1. Save `OWNw` and `SUBw` (read back through FCh).
2. Map the page: `OWNw` = its bank, `SUBw` = its 8K.
3. `LDIR` (or `CPIR`-style compare, or `INIR`/`OTIR`-style port transfer).
4. Restore `OWNw` and `SUBw`, re-enable interrupts.

The mover runs from EXROM chunks 0–1 and never maps a window there, so it
never unmaps itself. It doesn't depend on the Timex bank API, so the RAM disk
can ship before that API is fixed ([Phases](#phases)).

### From BASIC

| Command | Does |
|---|---|
| `SAVE "r:name" …` | every form `SAVE` takes: `LINE`, `CODE`, `SCREEN$`, `DATA` |
| `LOAD "r:name"`, `VERIFY "r:name"`, `MERGE "r:name"` | as from tape, with the same reports |
| `CAT "r:"` | the directory, with free space |
| `ERASE "r:name"` | delete |
| `MOVE "tpi:name" TO "r:name"`, and back | copy between the SD card and the RAM disk; MOVE copies, as it does today |
| `FORMAT "r:"` | create an empty RAM disk (asks Y/N, as `tpi:` FORMAT does) |
| `SAVE "tpi:ram backup name"` / `"tpi:ram restore name"` | the whole RAM disk to or from an image file on the SD card |
| `SAVE "tpi:ram"` | board found or not, `BASE`, `SIZE`, battery, write-protect switch, RAM disk size and free space |

Names follow the tape rules (up to 10 characters), so a file moves between
tape, SD card and RAM disk unchanged. Because `LOAD "r:name"` goes through
the ROM's own LOAD, a BASIC program, arrays and `SCREEN$` all behave exactly as
they do from tape.

### Where it lives on the board

The RAM disk occupies **the top of the board's banks**, growing down; banks
below it are free for programs. `FORMAT "r:"` asks for a size (default: half
the board).

- **Superblock** in the first 256 bytes of the RAM disk's top page: a magic
  number ("TSRD"), format version, the first and last page of the RAM disk, the
  cluster size, a **generation counter**, and a checksum.
- **Allocation bitmap** and **directory** in the rest of the top page(s).
  A directory entry is 32 bytes: the name, the 17-byte tape header's fields
  (type, length, start, program/array parameters), the first cluster and
  length, flags.
- **Files are contiguous**, in 1K clusters, and files of 8K or more start on a
  page boundary. A program can then map a file's pages directly: `LOAD
  "r:icons"` once, then page the icons in by number. When free space is too
  fragmented for a new file, the firmware compacts the disk with op 6.
- **Caching.** The firmware reads the superblock (op 4, 256 bytes) at the start
  of every `r:` command and re-reads the directory only if the generation
  counter changed. Every change to the directory increments it. That covers
  resets, power cycles and a second TS-Pico.

**Allocating pages for a program**, so programs and files never collide, is
a `tpi:ram alloc` command that reserves pages below the RAM disk and records
them in the superblock. Its exact form is for Jon, the GUI author, to shape (open
question 8).

## Channels (phase 9)

`OPEN #n,"r:name"[,"mode"[,reclen]]` opens a RAM disk file as a stream,
the way `OPEN #n,"f:name"` opens a file on the SD card: then `PRINT #n`,
`INPUT #n`, `INKEY$ #n`, `LIST #n` and `CLOSE #n`. The RAM disk becomes
random-access data storage for BASIC: record files read and written in
place, kept through power-off by the battery. **Proposed, not yet decided.**

The model is the TS-Pico's `f:` channel, which works today. Its references,
in tspico-firmware-build: `docs/reference/flows/channels.md` (the flow end to
end), `docs/reference/rom/exrom-fdd.md` ("The channel driver"),
`docs/reference/rom/home.md` (the three hooks and the HOME stubs at
1488h–14C5h), `docs/reference/firmware/channels.md` (modes, records, TAB).

### What `f:` already settled

These hold for any channel on the 2068, and `r:` keeps every one:

- **The record lives in CHANS.** MAKE-ROOM's POINTERS moves CURCHL, so a
  record above the workspace breaks `INPUT #`; a record in the program loses
  its offset when CHANS grows.
- **Both bytes of the stream's offset stay below 80h.** SELECT (HOME 1230h)
  takes a STRMS entry whose two bytes OR to 80h or more as a banked channel
  and looks it up through SYSCON (1265h). The `f:` OPEN pads each record to
  keep clear of that.
- **Allocations are multiples of 256 bytes**, so closing one moves other
  streams' offsets by their high byte only, and the pads stay right.
- **Records hold fixed HOME addresses** (14A0h, 14A9h), never module
  addresses, so nothing in a record goes stale when the module is rebuilt.
- **Every entry from HOME runs under `DI`** (the bank switch writes FFh then
  F4h; an interrupt between them runs `RST 38h` over the empty DOCK), and
  **inside GUARDED**, so a report raised inside the module restores the bank
  stack through H_TRAP (HOME 14B2h).
- **CURCHL and IY are kept.** A channel routine runs inside someone else's
  `PRINT #`; anything it prints would move the current channel to the screen.
- **CLOSE # takes the record out** and fixes up the others: streams above it
  move down, CURCHL goes to S if it pointed into the record. Stock CLOSE #
  crashes on an unknown letter (its table at 1407h has no terminator), so
  the hook must catch every letter the module creates.

### Question 1: CHANS records or Timex's banked channels

The 2068 ROM has Timex's path for channels whose code lives in an expansion
bank: SELECT's SYSCON lookup, the bank number kept in CRCBN (5CBFh), the
routines called through `CALL_BANK`, and CLCHAN's banked close (13D8h). The
Megabank is made of expansion banks, so it is tempting. **Recommended:
ordinary CHANS records, letter `R`, through the `f:` hooks.** The banked path
loses on every count:

- **It needs phase 8 first.** `CALL_BANK` does nothing useful until the bank
  API works on the board and `MAXBNK` is nonzero.
- **It is slow per character.** Every `RST 10h` would go through `CALL_BANK`
  (parameter frame, `SAVE_STATUS`, `BANK_ENABLE`, `RESTORE_STATUS`), against
  the `f:` stub's one thunk.
- **The code has to live in a bank.** The board is RAM: the driver would be
  copied there at boot from the EXROM, into pages the RAM disk and programs
  also use, and would run from memory any program can overwrite.
- **There is no way in.** The banked OPEN path at HOME 1488h was never
  reachable, and the TS-Pico ROM has rewritten those 55 bytes as its own
  stubs. A new OPEN path would be needed anyway, and the `f:` one exists.
- **SYSCON holds at most 10 entries** (open question 9), and Timex's banked
  path is untested code on a ROM where every other part of the bank API has
  turned out broken.

So `r:` needs **no new HOME bytes**: an `R` record holds the same 14A0h and
14A9h as an `F` record, and the module's `G_OUT`/`G_IN` choose `CH_OUT` or
the `r:` routines by the record's letter (one compare per character). The
changes to the existing driver:

- `CH_OPEN_HOOK` recognises `r:` beside `f:` and `d:`.
- `CH_CLOSE_HOOK` closes `R` records as well as `F` ones; the fix-up of other
  streams moves them by the closed record's own allocation (512 bytes for
  `F`, 256 for `R`) instead of a constant.
- `G_BEEP` skips the key click for `R` records too, so reading is silent.

The banked-channel route stays unused; nothing here depends on open
question 9.

### Question 2: where the bytes go

Two ways to carry a `PRINT #` byte to the board:

- **Through the firmware**, as `f:` does: the ROM buffers 64 bytes, sends
  `tpi:chwr` with the bytes as hex over port 0Eh, and the firmware, which
  can't reach the board, has the mover copy them back from the TS-Pico into
  the page (op 5). Every byte crosses the bus twice, and reading back is the
  `tpi:chrd` data phase at about 75 µs a byte.
- **Straight to the board** from the ROM, through the mover's window: map
  the file's page into a window chunk, store or fetch the byte, restore the
  chunk.

**Recommended: straight to the board, with the firmware involved only at
OPEN, CLOSE and when a file must grow.** The firmware stays the owner of
the file system (names, allocation, the directory); the ROM owns only an
open file's bytes, inside an extent the firmware gave it.

- **Speed.** The window costs about a dozen port accesses (save `OWNw` and
  `SUBw`, map, restore) and the position arithmetic: an estimated 400–500
  T-states per character, about 0.15 ms, on top of the stub, thunk and
  GUARDED cost every `f:` character already pays. No exchange with the
  TS-Pico, no SD card, nothing to wait for. (Estimates; measure in the
  emulator.)
- **No buffers.** Each `PRINT #` byte is on the board when `RST 10h`
  returns, and `INPUT #` reads one byte at a time with no read-ahead. So the
  record is small (256 bytes, mostly pad, against `f:`'s 512), a `u` stream
  needs no rule to stop a read running past a line, and nothing is lost in a
  buffer at NEW or power-off.
- **The window rule** is the mover's: a chunk from 4–7 holding neither the
  stack nor the `R` record (CHANS can reach chunk 4 with many streams open),
  saved and restored, under the `DI` every entry already has. A program's
  own mapped pages survive every `PRINT #`.

**OPEN, CLOSE and growth go to the firmware** through the channel driver's
`CH_SEND`, with the mover running inside the exchange (the firmware may
read or write the directory), ending with op 0's report code:

1. **OPEN** sends the stream, mode, record length, name and `STATUS` (so the
   firmware refuses writing with the write-protect switch on). The firmware
   finds or creates the file and gives it an **extent**: its start on the
   board and the bytes allocated. A file opened for writing gets the free
   run after it as room to grow (trimmed at CLOSE). It writes the stream's
   **slot** on the board (below), and the ROM copies the slot into the
   record.
2. **Growth:** a write past the extent asks for more. The firmware extends
   the file in place, or moves it (op 6) and gives a new extent; no room is
   the RAM disk's full report, with the file intact up to there.
3. **CLOSE** writes the final length and position to the slot, pads an open
   record, and tells the firmware, which writes the length into the
   directory and trims the extent.

### Slots, power-off, NEW and reset

**The open-file slots**: one per stream 0–15, 32 bytes each, in the RAM
disk's top page after the superblock and outside its checksum. A slot names
the directory entry, the extent, the length, the position, the mode and the
record length. The firmware writes it at OPEN; while the stream is open the
ROM keeps the working copy in the record and **writes the length and
position back to the slot at every CR, whenever the position crosses a
256-byte boundary, and at CLOSE** (one window mapping each time). The ROM
reads `STATUS` at each write-back: the switch turned on mid-stream is
reported then, not silently dropped writes.

**Every `r:` command carries an open-stream mask**: a bit for each stream
0–15 whose STRMS entry points at an `R` record. The firmware closes every
slot whose bit is clear: its length goes into the directory and the slot is
freed. That covers, with nothing to clean up by hand:

- **Power-off and reset:** the boot report (open question 3) carries a mask
  of 0, so every slot is closed. A file being written keeps everything up to
  its last CR or 256-byte boundary; the bytes after it are on the board but
  outside the length.
- **NEW,** which empties CHANS and STRMS without the ROM noticing: the next
  `r:` command's mask closes the slots. (`f:` handles NEW by replacing a
  stale entry at the next OPEN of the same stream; the mask is stricter.)
- **A program that clears a STRMS entry by `POKE`.**

The firmware reads the slots with the superblock at the start of each `r:`
command, so `CAT "r:"` shows an open file's current length.

**While a file is open** the firmware never moves it except to grow it for
its own stream, and refuses (Report F, as `f:` documents for a second OPEN
but never enforced): `ERASE` of it, `SAVE` over it, `MOVE` to it, a second
OPEN of it for writing, and `FORMAT "r:"` while any slot is open. Several
streams may read one file. Compaction treats open files as fixed.

### Question 3: modes, records, text

**Modes,** as `f:`: `r` read (the file must exist, else F), `w` write
(created or emptied), `a` append (created if missing, position at the end),
`u` update (created if missing, position 0, read and write), each with an
optional `b`. No mode is `r`. Output to an `r` stream is dropped (INPUT #'s
prompt goes to the stream too); `INPUT #` on `w` or `a` is Q. End of file is
NC NZ from the input routine, which WAIT-KEY turns into **8 End of file**.

**Records,** as `f:`: `OPEN #4,"r:data","u",30` makes a record file (1–254;
otherwise Q).

- `PRINT #4;TAB n;…` and `INPUT #4;TAB n;…` go to record *n*: TAB arrives
  as 23, lo, hi through the output routine, and the ROM computes the
  position, (*n* − 1) × reclen, itself. On a stream file `TAB n` is byte *n*.
- A CR ends the record and isn't stored; a short record is padded (spaces,
  or 0 in binary); a record that would run over its length is Q on the PRINT
  that made it, with nothing written; a record left open by `;` is padded at
  CLOSE; a TAB past the end pads the gap.
- Reading gives one record and a CR. `TAB 0` then a read gives the number of
  records (or bytes); `TAB 0` with data is Q.

Random access is where `r:` is far ahead of `f:`: each `f:` seek and record
is a command to the TS-Pico and an SD card mount, each `r:` one a
multiplication and a window.

**Text and binary.** `f:` translates on the Pico because its files are read
on a PC: keywords spelt out, LF line ends, UTF-8. An `r:` file stays on the
2068, so the ROM keeps its bytes as the 2068 wrote them, with a small
translation in text mode:

- **Text (default), writing:** colour and position controls (16–21 with one
  parameter, 22 with two) are dropped, the comma control (6) becomes spaces
  to the next 16-column stop (the record keeps a column), other controls
  except CR are dropped. Keywords stay single token bytes, so `LIST #4` then
  `INPUT #4;LINE a$` gives the line as the 2068 shows it, and `"a|b"`
  round-trips (unlike `f:`).
- **Text, reading:** LF and CRLF become CR, so a text file MOVEd in from the
  SD card reads line by line; other control bytes are dropped, so `INPUT #`
  never acts on them as editing keys.
- **Binary:** every byte as it is, except that 23 is always TAB (as `f:`).
  `INKEY$ #` is the way to read raw bytes.

Channel files are stored as `CODE` files with start 0, so `LOAD "r:name"
CODE addr` works on them, and any `r:` file (a SAVEd program, a screen) can
be opened `rb` to read its bytes. `MOVE "r:name" TO "tpi:name"` copies the
bytes unchanged: whether it should translate text files to PC text, as an
`f:` file would be, is open question 14.

### Other streams on the RAM disk

- **A listing:** `OPEN #5,"r:"` reads the RAM disk's names, one per
  `INPUT #5`, then 8 End of file; `TAB 0` gives the count. As `d:`, it is
  read-only. The firmware writes the names into a hidden scratch file and
  opens it `r`, so the ROM reads it like any other file.
- **Capturing the printer:** `OPEN #3,"r:listing","w"`, then `LLIST` or
  `LPRINT`, then `CLOSE #3`. Needs checking that `CLOSE #3` puts P back, as
  it should for `f:` (testing).
- **Data that outlives a program:** a file written by one program and read
  by the next after `NEW` or `LOAD`, without the SD card. This is what the
  settings and save games of Jon's GUI need (open question 8).

### Coexisting with `f:`

Both kinds of record sit in CHANS under the same hooks and the same rules,
told apart by the letter. An `F` and an `R` stream can be open together; an
OPEN of a stream already open to either is **O Invalid stream**, as today.
`f:` commands never touch the board, and `r:` characters never talk to the
TS-Pico, so neither slows the other; their OPEN and CLOSE exchanges share
`CH_SEND`'s IDLE wait. The `f:` driver's own code doesn't change beyond the
three points under Question 1.

**ROM space.** The `r:` routines (open and close glue, the output and
input routines with text mode, records and TAB, the slot write-back) are
estimated at 600–900 bytes, in EXROM chunk 1's free space beside the
mover (5,239 bytes free before phase 4).

## Firmware

All on the v3 card; v2 is out of scope **(decided)**.

**Core 1 (C, `tsbus.c`): share the bus.**

1. In the OUT snoop (`tsbus.c` 858–906, beside the F4h/FFh shadow): port FDh
   stores the register number; port FCh, when that number is 00h–07h, stores
   the owner in `sh_own[n]` and resets `sh_sub[n]`. A change rewrites the
   chunk table.
2. `chunk_target` (`tsbus.c` 322) returns `tail` (not ours) for any chunk with
   `sh_own[c]` in 1–253, before looking at F4h and FFh.
3. The DOCK-write path (`tsbus.c` 908) skips owned chunks.
4. `sh_own` clears at power-on and on the card's own reset handling, and is
   resynchronised by the ROM's boot-time writes.

That's a few dozen lines on the existing, proven path: the same mechanism
that already follows F4h and FFh. Owner writes are I/O cycles, which last
over a microsecond, so the table is current before the next memory read.

**Core 0 (Python): the RAM disk.** A new module beside `extcmd.py`:

- the `r:` file system: the format above, allocation, compaction;
- the mover's side of the protocol: sending operations, checking status;
- the `CAT`/`ERASE`/`MOVE`/`FORMAT` handlers for `r:` names;
- `tpi:ram` (info, backup, restore, alloc);
- later (phase 9), the `r:` channels' OPEN, growth and CLOSE, the open-file
  slots and the open-stream mask ([Channels](#channels-phase-9));
- what the ROM reports at boot: board found, `BASE`, `SIZE`, `STATUS`.
  The firmware can't read the board itself, since it can't run bus cycles.

## PicoVideo

PicoVideo (github.com/timex-sinclair-projects/PicoVideo, v4.2) already sees
everything it needs: its GAL passes every I/O cycle to the Pico, and every
memory write to 4000h–7FFFh. It already skips a screen write when port F4h
maps chunk 2 or 3 away from HOME. The change, in `coreB/busMain.c`:

1. Two cases in the I/O-write `switch (gZ80AdrL)`: FDh stores the register
   number; FCh stores the value if that number is 02h or 03h (the owners of
   chunks 2 and 3). PicoVideo needs only whether a bank owns the chunk, not
   which 8K it shows, so it ignores `SUB`.
2. The two memory-write tests skip the write when the chunk's owner is 1–253,
   alongside the existing F4h tests.

About 15 lines. It applies unchanged to an RP2350 re-spin. The boards already
built need only a new UF2. **Without the update,** a PicoVideo shows stray
writes whenever a program maps a bank into chunk 2 or 3; nothing else is
affected.

While there: `case 0xF4:` has no `break` and falls into `case HIRES_ADRL`,
so every `OUT F4h` also overwrites the low byte of the hi-res address. One
line to fix.

**Exploration:** PicoVideo folded into this card as a second RP2350B, with
DVI/HDMI out of its HSTX, the AY in the HDMI audio, and a private path to
the SRAM for Jon's accelerated video:
[picovideo-merge.md](picovideo-merge.md).

## Bus mastering (revision 2)

Not this board. Jon (TS2068 list, 2026-10-20 and 22) proposes REU-style DMA:
the board taking the bus with /BUSRQ and writing frames from the banks
straight into the screen. That is possible through the SCLD's normal path,
not around it: the master has to make memory cycles the SCLD accepts. This
records what it would take, so the decision is there when a revision is.

**What the SCLD needs** (from Load ZX's TC2068 model, `rtl/scld.vhd` and
`rtl/scld_contention.vhd`; the US SCLD to be measured):

- **Z80-shaped cycles on the 2068's clock.** The SCLD latches its DRAM
  address multiplexer on a rising CPU clock edge after /MREQ falls, and makes
  the write strobe from /MREQ, /WR and the address. A master holds /MREQ and
  /WR over the same clock edges as a 3-T Z80 write, and steps on CLK (finger
  B9), since contention works by stopping that clock.
- **/BE released.** The SCLD's write strobe needs /BE high: a master writing
  HOME must not pull it, and the board's own `serve` path, which sees the
  master's cycles on the bus like any others, must be held off meanwhile.
- **The free windows.** The SCLD fetches the picture in the first half of
  each of the 192 picture lines: about 27 µs a line, about 5.3 ms a frame,
  are free, plus about 4.4 ms of border and blanking. About 58% of a frame.
- **Refresh.** The Z80 does no refresh while it has given up the bus, and it
  does not float /RFSH, so a master can't make refresh cycles. Bus holds must
  stay short: a natural pattern is to hold the bus in the free half of each
  picture line and give it back in the fetch half, when the Z80 would be
  contended anyway. A single hold across all of the blanking would pass the
  DRAM's 4 ms.

**What the board would change:**

| What | This board | Revision 2 |
|---|---|---|
| U1/U2, address | Fixed inward, always on | Direction and enable from the controller: in (normal), off (the controller addresses the SRAM privately), out (a master cycle). |
| A8–A12 | To the SRAM only | Also to the controller, for private SRAM addresses and master cycles: 5 GPIOs, or 2 for a 74LVC573 loaded from SD0–SD7 (the high byte changes every 256 bytes). |
| /MREQ, /RD, /WR, /IORQ | Inward on U4 | A 74LVC245 of their own, sharing U1/U2's direction and enable. With it off, the controller drives the local /RD and /WR nets, which already feed SRAM /OE and the /WE gate. |
| U3, data | DIR = bus /RD | DIR = /RD XOR "master" (a 74LVC1G86), since a master write holds /RD high. |
| /BUSRQ (A23) | Not connected | Out through a third 74LVC1G06, open-drain: 1 GPIO. |
| /BUSAK (A21), CLK (B9) | Not connected | In, on the U4 channels freed above: 2 GPIOs. |
| /RFSH | Inward | Unchanged (above). |

**Independent source access** is what makes the private SRAM state needed:
one address bus can't select a byte in a bank and a different byte in HOME
at once. The controller reads the source with U1/U2 off, then drives the
host write.

**Pins are the obstacle.** That is about 10 more GPIOs; the RP2350B has 2
spare (46 of 48 used), on test pads TP4 and TP5 so that the handshake can be
tried on the bench with a second board wired to them. A latch for A8–A12 saves 3, an I²C expander for
BAT_EN, the write-protect switch and the /NMI output 1 more, dropping the
/NMI input 1 more (/INT stays: a master needs it for frame sync). Still about
3 short. So revision 2 probably adds a **second controller**, an RP2350A on
the board's local buses as the bus master, with the RP2350B keeping the
memory map. The same chip is where Jon's onboard processing (decoding,
compositing) would run.

**Other cards** see a master's writes as Z80 writes: PicoVideo mirrors them
into its display, as wanted. The v3 card must not answer chunks 2–3. Another
card using /BUSRQ would need arbitration.

**The first test** (Jon's): a few host-clocked writes to HOME outside the
picture fetch, from a small local buffer, /BE released, watching address,
data, the DRAM strobes and the buffer directions; then the same during
contention, checking that the stretched cycle completes. It needs master
hardware: neither this board nor the v3 card can run bus cycles.

## Testing

**Before any hardware:**

1. **Does the 2068 itself answer FCh or FDh?** The Spectrum's ULA answers
   any even port. If the 2068's SCLD decodes FEh partially, `OUT 252,n` would
   change the border and `IN 252` would read the keyboard, colliding with the
   board. In BASIC: `OUT 252,2` (border red?), `OUT 253,2`, and
   `PRINT IN 252, IN 253` with no keys pressed (FFh means nobody answered).
   **Done (2026-10-16), on David's 2068 with the TS-Pico fitted:** `OUT 252,2`
   and `OUT 253,2` left the border alone; `IN 252` and `IN 253` each drift
   between 127 and 255 from one read to the next, whatever keys are held,
   while `IN 254` reads the keyboard (30 with ENTER still down). So nothing
   answers FCh or FDh: the reads are a floating bus, D7 keeping whatever
   charge is left on it. **FCh/FDh stand (decided).**
2. **The 2068's own data buffers stay off for FCh/FDh.** Step 1 cannot
   show this: a buffer turned on facing an undriven bus reads as a floating
   bus too. If the SCLD turns on the 2068's data buffers (U5 and U9,
   74LS245) for an I/O cycle it does not answer, then on `IN` from FCh/FDh
   they fight the board's data buffer. Gustavo's test: a logic analyser on
   pins 1 (DIR) and 19 (/G) of U5 and U9, with /IORQ, /RD, /WR and /M1, and
   this program, assembled with ZEUS and run:

   ```
   10 org 40000
   20 ent
   30 DI
   40 LD B,0          ; 256 passes
   50 LBL1: IN A,(#FC)
   60 IN A,(#FD)
   70 OUT (#FC),A
   80 OUT (#FD),A
   90 DJNZ LBL1
   100 EI
   110 RET
   ```

   (Gustavo's listing has `LD B,256`; B is 8 bits, and 0 gives the same 256
   passes.) Pass: none of the four pins changes state in any of these I/O
   cycles. Run it with nothing on the bus and again with the TS-Pico fitted.
   Eight channels at 24 MHz are enough (an I/O cycle is about 1 µs): a
   USB analyser of the fx2lafw kind with PulseView takes 5 V inputs. The v3
   card can't stand in for one: U5 and U9 are on the 2068's board, not the
   edge connector, and v3 doesn't bring in /M1.
   The v3 card answering `IN 0Eh` without trouble is a good sign, not proof:
   FCh and FDh sit next to the SCLD's own F4h, FEh and FFh. If they do
   change, see open question 15.
3. **An emulator model.** Add the board to our ZEsarUX fork (memory reads and
   writes through the owner table, ports FCh/FDh). The ROM and firmware can
   then be developed and tested with no hardware, through the existing
   `tools/emu` bridge. **Done (2026-10-16), merged:**
   [zesarux-tspico#2](https://github.com/timex-sinclair-projects/zesarux-tspico/pull/2),
   documented in its `MEGABANK.md`. Off unless `MEGABANK_FILE=path` (the RAM
   kept in that file: the battery) or `MEGABANK=1` is set; `MEGABANK_BASE`,
   `MEGABANK_SIZE` and `MEGABANK_WP` configure it. `tspico/megabank_test.py`
   checks it over ZRCP on the stock ROM, in CI. Not modelled: timing, the
   battery-low bit, snapshots. Note for test scripts: ZEsarUX's hard reset
   does nothing on a TS-2068; use its plain reset (`reset-cpu`).
4. **ROM host tests** for the mover's window choice and the boot-time
   detection, in the style of the existing `rom_*_hosttest.py`.
5. **Firmware host tests** for the file system: format, save/load/erase,
   fragmentation and compaction, a corrupt superblock, the generation counter.
6. **The controller's firmware** on an RP2350B development board, with the
   v3 card's PIO programs as the starting point: register writes and reads,
   the owner table, /BE and the page bits against a logic analyser, before
   any Megabank PCB exists.

**On hardware:**

1. A prototype on the extender, with a scope on /BE, /MREQ, /RD and D0–D7, in
   every slot: /BE must win against the 2068's own memory with margin
   (open question 2).
2. A memory test from the 2068: every page, every chunk, pattern and
   address-in-address, with the v3 card and PicoVideo both plugged in.
3. Battery: fill the board, power off for a day, verify; measure the standby
   current.
4. Power-fail: switch off during a long `SAVE "r:"`. Other files must survive;
   the one being written may be lost.
5. The RAM disk end to end: every SAVE/LOAD form, MOVE both ways, backup and
   restore, a full disk, compaction.
6. `tools/hwcheck.py` grows a RAM-board section.

**Channels (phase 9),** in the emulator first, as `f:` was:

1. `PRINT #`, `INPUT #`, `LIST #`, `INKEY$ #` in every mode; records with
   `TAB` both ways; reading past the end; a file that must grow and move.
2. A few thousand characters through a stream with a program's own page
   mapped in each of chunks 4–7: the page must survive, the stream must not
   crash.
3. 32 errors in a row inside the channel (the `f:` bank-stack test).
4. `f:` and `r:` streams open together; closing them in every order (the
   offset fix-up with 256- and 512-byte allocations).
5. NEW, a reset and power-off with a stream open: the file keeps everything
   to its last CR, its slot is closed, `ERASE` then works.
6. The write-protect switch turned on mid-stream.
7. `OPEN #3,"r:…"` with `LLIST`, then `CLOSE #3`: P must come back.
8. The cost per character, against the estimate.

## Phases

Each phase is its own branch and PR, and each PR updates the programmer's
reference for what it changes.

1. **Port test** on a 2068 (testing step 1). **Done (2026-10-16):** FCh/FDh
   stand. Still to do: the buffer test (testing step 2).
2. **Emulator model** in the ZEsarUX fork. **Done (2026-10-16):**
   [zesarux-tspico#2](https://github.com/timex-sinclair-projects/zesarux-tspico/pull/2),
   merged into `tspico-device`; its test passes on macOS, Linux and Windows.
3. **v3 firmware: bus sharing** (core 1). Small, and testable in the emulator
   and on a v3 card with no board (nothing changes until something writes
   FDh/FCh).
4. **ROM: detection, boot reset and the mover**, plus the `r:` hook.
5. **Firmware: the RAM disk** and `tpi:ram`.
6. **PicoVideo** update (its own repo).
7. **Board:** schematic, the controller's firmware, PCB (assembled by
   JLCPCB), prototype, hardware tests. **Routed (2026-10-18; re-routed 2026-10-19 with /INT and /NMI):** schematic
   generated (ERC: one expected warning), v3's form factor, routed by v3's
   flow, DRC clean; not yet ordered ([hardware/](../hardware/README.md)). Can run
   in parallel with 2–6 once the register map is agreed.
8. **ROM: the Timex bank API** made to work on the board (see [ROM](#rom)).
   Last, because nothing above depends on it. David leans towards only what
   the board and RAM disk need, and is open to the whole API (open question 5).
9. **ROM and firmware: `r:` channels** ([Channels](#channels-phase-9)).
   Depends on 4 and 5 only, not on 8, so it can go before it.

## Open questions

1. **Do ports FCh/FDh collide with the 2068 itself?** **Answered
   (2026-10-16): no** ([Testing](#testing), step 1). A repeat with nothing on
   the expansion bus would remove the last doubt; the TS-Pico answers only
   0Eh/0Fh. That the 2068's data buffers stay off is still to be measured
   (testing step 2, open question 15).
2. **/BE timing** through the expansion bus, in every slot, with the v3 card
   and PicoVideo fitted. Measured on the prototype. The v3 card's PIO path
   already wins this race on a 2068; the board's must too. Also measured: how
   the page bits are produced (a second PIO table, a DMA-chained lookup or
   core 1), and that they settle well inside the read.
3. **How the ROM tells the TS-Pico about the board at boot**: a new command,
   or a field in an existing boot exchange. Decided when the ROM work starts,
   with `docs/PROTOCOL.md`.
4. **A write fence for the RAM disk?** `WPROT` protects only chunks that are
   mapped. A program that maps a RAM disk page by mistake can still corrupt
   files. A `FENCE` register (banks at or above it are read-only unless
   unlocked) would close that, at the cost of a register the ROM must set at
   boot.
5. **Scope of the Timex bank API work**
   ([ROM](#the-timex-bank-api-on-the-board-phase-8)): items 1–5 (the API
   works with the board) or all of it. David leans towards the minimum.
6. **Parts, for JLCPCB assembly** ([Hardware](#parts)):
   - **The SRAM.** The ×8 mode is confirmed in both datasheets. Still open:
     whether the DV30 is current (its only datasheet found is from 2006; the
     EV30's is Infineon's, 2020), and stock, which is thin at JLCPCB (42 EV30s
     and 168 DV30s on 2026-10-16). The BHE/BLE difference between them is
     handled by the 0 Ω pads. If it runs out, switch to the
     IS62WV51216 (3,623 in stock), a different footprint, before layout. The
     earlier candidates were not at JLCPCB on that date: AS6C4008 (5 left),
     AS6C8008, CY62177G30, IS62WV20488, and Everspin MRAM.
   - **The RP2350B's stepping.** Use a stepping without the E9 pad erratum
     (a pull-down that latches), or don't rely on internal pull-downs.
   - **The edge fingers' sides:** confirm that side A is the top, as v3
     assumes.
7. **A name** for the board.
8. **What Jon, the GUI author, needs** from `tpi:ram alloc` and from the ROM: page
   allocation from BASIC, a machine-code entry point, a page size other than
   8K? Worth showing him this document. **Partly answered (2026-10-27)** by
   his ZXDesk, a GUI that takes the machine over ([ZXDesk](#zxdesk)):
   - **Its first need takes nothing from the ROM:** a storage backend in
     eight pages (a directory and seven 8K files), mapped one at a time
     into chunk 7 by the board's registers. 8K pages suit it: they are
     the size of its 128K backend's files.
   - **It never calls the ROM** once running, so a ROM entry point is no
     use to it while it runs. Allocation must be something its BASIC loader
     does before `RANDOMIZE USR` (`SAVE "tpi:ram alloc zxdesk 8"`, say,
     leaving the first page's number where the program can find it), or
     something the program can read for itself from the superblock, by
     mapping the RAM disk's top page. The allocation needs a name, so the
     program finds the same pages at every start.
   - **Until then** it uses the board's first bank, pages 0–7.
     `tpi:ram alloc` must then hand those pages to ZXDesk rather than to
     someone else, or ZXDesk must move its files when it first sees an
     allocation.
   - **Still open:** whether `r:` files from a program that has taken the
     machine over (notes swapped with BASIC) are worth a machine-code
     entry to the mover, and that entry's form.
9. **SYSCON entries for RAM banks.** SYSCON holds at most 10 entries (its
   scratch space at 5FE9h–5FFFh is hard-coded). Nothing validates bank numbers
   against it, so RAM banks may not need entries at all; decide in phase 8.
10. **The bank stack** holds 16 frames of 4 bytes with no overflow check.
    Deep `CALL_BANK` nesting could overrun it. Phase 8.
11. **The controller's firmware and settings.** How its firmware is loaded
    (a surface-mount USB-C connector, or SWD pads), and how `BASE` and `SIZE`
    are set: over USB, or from the 2068 through a guarded register
    (`SAVE "tpi:ram base 65"`, say).
12. **Standby with the controller off.** Settled on paper for the EV30
    ([Parts](#parts)). Still to check: that no path lets the battery feed the
    RP2350B or the buffers, and the real standby current on the prototype
    (hardware test 3), with the DV30 too if it is fitted.
13. **Where the bus's /BE pull-up is.** The board's /BE driver is open-drain
    and the board adds no pull-up, relying on the one already on the bus.
    Confirm where that is (the 2068, or the v3 card) and that it is strong
    enough for /BE to rise between cycles with the board fitted.
14. **Channels** ([Channels](#channels-phase-9)): agree the recommendations
    (CHANS records with the `f:` hooks, direct access through the window,
    the slots and the open-stream mask, text mode in the ROM). Still open:
    whether `MOVE "r:…" TO "tpi:…"` translates a channel text file to PC
    text (keywords spelt out, LF), as an `f:` file would be; whether
    listings take a pattern, as `d:` does; and how the open-stream mask
    travels in `r:` commands (decided with `docs/PROTOCOL.md`, with open
    question 3).

15. **If the 2068's data buffers turn on for FCh/FDh** (testing step 2),
    how the board keeps them off. First check whether /BE disables them in
    an I/O cycle as it does in a memory cycle; if so, the controller pulls
    /BE for its own `IN`s too (a firmware change). If not, other ports, or a
    board change. Either way the board must not drive D0–D7 against them.
16. **/INT and /NMI on the board** (Gustavo's suggestion). **Added
    (2026-10-19):** /INT (finger A14) and /NMI (A15) come in through a
    74LVC2G34 to GPIO43 and GPIO44, and GPIO45 pulls /NMI low through a
    second 74LVC1G06, open-drain like /BE. The controller can see the frame
    interrupt and raise NMIs of its own, for mapping that the Z80 does not
    set up through FCh/FDh. Still open: what the firmware does with them. No
    register uses them yet. Note that the v3 card also drives /NMI (its
    button and firmware), so an NMI handler can't tell who raised it unless
    the board says so in a register.
17. **SYSCON's space and the TS-Pico.** An analysis of Gustavo's ROM
    describes 5DDDh–633Fh as reserved for future TS-Pico releases. That
    range takes in SYSCON's table (5EEAh–5FFFh), which FOR, RESTORE and USR
    read on every 2068 ([What the ROM needs from
    SYSCON](#what-the-rom-needs-from-syscon)). Ask Gustavo what is planned
    there. The firmware repo itself shows no such reservation: its ROM uses
    only 5D37h and 5DCDh–5DDBh in that range.
18. **Extended RAM for BASIC.** Using the board for BASIC's own program
    and data, as BASIC XE and BASIC 7.0 did, is explored in
    [basic-extended-ram.md](basic-extended-ram.md): overlays and page
    files first, then the program text in banks (EXTEND), sharing the
    ROM's AROS path with the cartridges that use it. The direction is
    decided; the design is not.
19. **Is a bank in chunk 2 or 3 contended?** The SCLD manages the 2068's
    lowest 16K (4000h–7FFFh): Z80 accesses there go through it and are
    slowed while it fetches the picture, and it keeps generating video when
    the Z80 maps something else over those chunks. When the board owns
    chunk 2 or 3 and pulls /BE, does the SCLD still stretch the clock? That
    depends on whether its contention logic looks at /BE (its HOME select) or
    only at A14–A15 and /MREQ. If the latter, the board in chunks 2 and 3
    runs at contended speed, not "full memory speed". To test: time a loop
    of reads from a bank in chunk 2 and in chunk 4, during the picture, or
    watch CLK on a scope. Raised by David (2026-10-20) after Jon's video
    proposal, which also suggests a use if the answer is "uncontended":
    PicoVideo could take uploads written into a bank-owned chunk 2 or 3 at
    full speed (its change under [PicoVideo](#picovideo) would then need a
    mode that keeps such writes rather than ignoring them).
    **The TC2068 model says contended (2026-10-22).** In Load ZX's VHDL
    model of the Portuguese SCLD (`rtl/scld_contention.vhd`), the CPU is
    held off when A15–A14 = 01 or /IORQ is low, during the first half of
    each of the 192 picture lines. It looks at neither /BE nor /MREQ (the
    /MREQ term is commented out). So a bank in chunk 2 or 3 is contended
    like the 2068's own RAM, and so are I/O cycles during the picture,
    FCh/FDh included. The model marks its /BE input "TBD", and the US SCLD
    may differ: the bench test stands, but plan on "contended". The model
    also has the SCLD strobing the upper 32K's CAS lines, uncontended.

## Sources

- LarKen Electronics, *Assembling the LARKEN RAMDISK* and *Adding the LARKEN
  RAMDisk to existing LKDOS System* (scans from David, with the 256K
  schematic, the parts placement diagram, and Jack Dohany's 2 × 128K
  variant).
- Timex Computer Corp., *Timex Sinclair 2068 Third Party Software Guide*,
  section 1 (memory and banks) and section 6 (SYSCON, the bank API);
  Technical Memo #0006, Connector Specification. Both in the archive.org item
  `timex-computer-corp`.
- Wes Brzozowski, "The Mystery of the Missing 253" and its four follow-ups,
  *Time Designs*, 1986–87, on timexsinclair.com.
- William Pedersen, "Bank Switching the Timex Sinclair 2068 Computer", parts
  I–IV, *T-S Horizons* #19–21; "TS 2068 Memory Expansion", *Nite-Times News*
  v3n2, 1989; both on timexsinclair.com.
- L. Crawford, "Other uses for the T/S 2068 LarKen RAMdisk", *Update*, April
  1990, on timexsinclair.com.
- PicoVideo v4.2, github.com/timex-sinclair-projects/PicoVideo
  (`PICOVID.PLD`, `coreB/busMain.c`).
- Load ZX Museum, A. Lopes, P. Cortesão, *timex_scld*, a VHDL model of the
  TC2068's SCLD (CC BY-SA 4.0), github.com/LoadZX/timex_scld
  (`rtl/scld.vhd`, `rtl/scld_contention.vhd`); links from Jon on the TS2068
  list, 2026-10-22.
- TS2068_Extender v2.1, github.com/timex-sinclair-projects/TS2068_Extender.
- tspico-firmware-build: `src/rom/TSPICO-23.ROM`, `ROMs/GENUINE-2068-exrom.bin`,
  `src/tsbus/tsbus.c` and `tsbus.pio` (the v3 card's `serve`, `io_snoop` and
  `io_drive` PIO programs), `docs/reference/rom/`.
- David's TS2068 reference library: the genuine HOME and EXROM disassemblies
  (`ts2068_home_rom_U16_stock.txt`, `ts2068_exrom_U20_stock.txt`), and
  Gustavo Pane's TS-Pico ROMs disassembled (`gus-home.asm`, `gus-exrom.asm`)
  with an analysis (`gus-rom-analysis.md`), for SYSCON's readers.
- tspico-hardware (the v3 card): the RP2350B core circuit, the 74LVC bus
  interface, `hardware/scripts/parts.py`, `jlc_price.py` and `gen_fab.py`.
- JLCPCB's parts catalog, queried with `jlc_price.py` on 2026-10-16 for the
  stock and prices under [Parts](#parts).
- Infineon, *CY62167EV30 Industrial MoBL 16-Mbit (1M × 16/2M × 8) Static
  RAM*, document 002-24706 Rev. \*B, April 2020; Cypress, *CY62167DV30 MoBL
  16-Mbit (1M x 16) Static RAM*, document 38-05328 Rev. \*G, July 2006.
- ISSI, *IS62WV51216ALL/BLL 512K x 16 Low Voltage, Ultra Low Power CMOS
  Static RAM*, Rev. B, February 2005 (through JLCPCB's link for C11315).
