timex-sinclair-projects/TS-2068-Megabank/docs/images/megabank-bottom.png

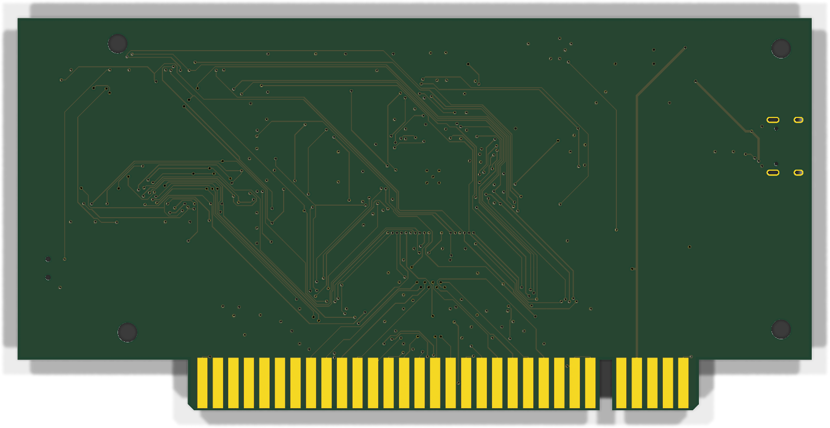
docs/images/megabank-bottom.png
