timex-sinclair-projects/TS-2068-Megabank/hardware/bom/megabank-bom-full.csv

Value | Reference | Footprint | MPN | LCSC | Qty
CR2032 | BT1 | Battery:BatteryHolder_Keystone_3034_1x20mm | 3034TR | C5213768 | 1
100n | C1-C7,C10-C12,C21,C23-C31,C37,C47,C48,C52,C54,C55 | Capacitor_SMD:C_0603_1608Metric | CC0603KRX7R9BB104 | C14663 | 26
4.7u | C20,C22,C39 | Capacitor_SMD:C_0402_1005Metric | CL05A475MP5NRNC | C23733 | 3
15p | C35,C36 | Capacitor_SMD:C_0603_1608Metric | CL10C150JB8NNNC | C1644 | 2
1u | C40,C53 | Capacitor_SMD:C_0603_1608Metric | CL10A105KB8NNNC | C15849 | 2
10u | C50,C51 | Capacitor_SMD:C_0603_1608Metric | CL10A106KP8NNNC | C19702 | 2
SS34 | D1,D2 | Diode_SMD:D_SMA | SS34 | C8678 | 2
USB-C | J1 | Connector_USB:USB_C_Receptacle_HRO_TYPE-C-31-M-12 | TYPE-C-31-M-12 | C165948 | 1
TS2068_Edge | P1 | megabank:TS2068_EdgeConnector_2x32 |  |  | 1
AO3401A | Q1 | Package_TO_SOT_SMD:SOT-23 | AO3401A | C15127 | 1
AO3400A | Q2 | Package_TO_SOT_SMD:SOT-23 | AO3400A | C20917 | 1
10k | R1,R2,R4,R10-R12,R21,R22,R50,R54 | Resistor_SMD:R_0603_1608Metric | 0603WAF1002T5E | C25804 | 10
0 | R13,R14 | Resistor_SMD:R_0603_1608Metric | 0603WAF0000T5E | C21189 | 2
1k | R20,R23 | Resistor_SMD:R_0603_1608Metric | 0603WAF1001T5E | C21190 | 2
5k1 | R24,R25 | Resistor_SMD:R_0603_1608Metric | 0603WAF5101T5E | C23186 | 2
33 | R26-R28 | Resistor_SMD:R_0603_1608Metric | 0603WAF330JT5E | C23140 | 3
100k | R51,R52 | Resistor_SMD:R_0603_1608Metric | 0603WAF1003T5E | C25803 | 2
1M | R53 | Resistor_SMD:R_0603_1608Metric | 0603WAF1004T5E | C22935 | 1
RUN | SW3 | Button_Switch_SMD:SW_Push_1P1T_XKB_TS-1187A | TS-1187A-B-A-B | C318884 | 1
BOOTSEL | SW4 | Button_Switch_SMD:SW_Push_1P1T_XKB_TS-1187A | TS-1187A-B-A-B | C318884 | 1
WP | SW5 | Button_Switch_SMD:SW_SPDT_Shouhan_MSK12C02 | MSK12C02 | C431540 | 1
SWCLK | TP1 | TestPoint:TestPoint_Pad_1.5x1.5mm |  |  | 1
SWDIO | TP2 | TestPoint:TestPoint_Pad_1.5x1.5mm |  |  | 1
GND | TP3 | TestPoint:TestPoint_Pad_1.5x1.5mm |  |  | 1
GP46 | TP4 | TestPoint:TestPoint_Pad_1.5x1.5mm |  |  | 1
GP47 | TP5 | TestPoint:TestPoint_Pad_1.5x1.5mm |  |  | 1
74LVC245APW | U1-U4 | Package_SO:TSSOP-20_4.4x6.5mm_P0.65mm | 74LVC245APW,118 | C6082 | 4
74LVC1G06 | U5,U6 | Package_TO_SOT_SMD:SOT-353_SC-70-5 | SN74LVC1G06DCKR | C7828 | 2
74LVC2G34 | U7 | Package_TO_SOT_SMD:SOT-363_SC-70-6 | SN74LVC2G34DCKR | C14461 | 1
CY62167EV30LL-45ZXIT | U10,U11 | Package_SO:TSOP-I-48_18.4x12mm_P0.5mm | CY62167EV30LL-45ZXIT | C511152 | 2
SN74LVC1G32DBVR | U12 | Package_TO_SOT_SMD:SOT-23-5 | SN74LVC1G32DBVR | C10096 | 1
RP2350B | U20 | Package_DFN_QFN:QFN-80-1EP_10x10mm_P0.4mm_EP3.4x3.4mm | RP2350B | C42415655 | 1
GD25Q128ESIGR | U21 | Package_SO:SOIC-8_5.3x5.3mm_P1.27mm | GD25Q128ESIGR | C2928891 | 1
ME6211C12M5G-N | U23 | Package_TO_SOT_SMD:SOT-23-5 | ME6211C12M5G-N | C236672 | 1
TLV1117LV33 | U30 | Package_TO_SOT_SMD:SOT-223-3_TabPin2 | TLV1117LV33DCYR | C15578 | 1
TPS3839G33 | U31 | Package_TO_SOT_SMD:SOT-23 | TPS3839G33DBZR | C485802 | 1
LM66200 | U32 | Package_TO_SOT_SMD:SOT-583-8 | LM66200DRLR | C3235556 | 1
12MHz | Y1 | Crystal:Crystal_SMD_3225-4Pin_3.2x2.5mm | ABM8-272-T3 | C20625731 | 1
