timex-sinclair-projects/TS-2068-Megabank/hardware/bom/megabank-jlcpcb-bom.csv

Comment | Designator | Footprint | LCSC Part #
CR2032 | BT1 | Battery:BatteryHolder_Keystone_3034_1x20mm | C5213768
100n | C1-C7,C10-C12,C21,C23-C31,C37,C47,C48,C52,C54,C55 | Capacitor_SMD:C_0603_1608Metric | C14663
4.7u | C20,C22,C39 | Capacitor_SMD:C_0402_1005Metric | C23733
15p | C35,C36 | Capacitor_SMD:C_0603_1608Metric | C1644
1u | C40,C53 | Capacitor_SMD:C_0603_1608Metric | C15849
10u | C50,C51 | Capacitor_SMD:C_0603_1608Metric | C19702
SS34 | D1,D2 | Diode_SMD:D_SMA | C8678
USB-C | J1 | Connector_USB:USB_C_Receptacle_HRO_TYPE-C-31-M-12 | C165948
TS2068_Edge | P1 | megabank:TS2068_EdgeConnector_2x32
AO3401A | Q1 | Package_TO_SOT_SMD:SOT-23 | C15127
AO3400A | Q2 | Package_TO_SOT_SMD:SOT-23 | C20917
10k | R1,R2,R4,R10-R12,R21,R22,R50,R54 | Resistor_SMD:R_0603_1608Metric | C25804
0 | R13,R14 | Resistor_SMD:R_0603_1608Metric | C21189
1k | R20,R23 | Resistor_SMD:R_0603_1608Metric | C21190
5k1 | R24,R25 | Resistor_SMD:R_0603_1608Metric | C23186
33 | R26-R28 | Resistor_SMD:R_0603_1608Metric | C23140
100k | R51,R52 | Resistor_SMD:R_0603_1608Metric | C25803
1M | R53 | Resistor_SMD:R_0603_1608Metric | C22935
RUN | SW3 | Button_Switch_SMD:SW_Push_1P1T_XKB_TS-1187A | C318884
BOOTSEL | SW4 | Button_Switch_SMD:SW_Push_1P1T_XKB_TS-1187A | C318884
WP | SW5 | Button_Switch_SMD:SW_SPDT_Shouhan_MSK12C02 | C431540
SWCLK | TP1 | TestPoint:TestPoint_Pad_1.5x1.5mm
SWDIO | TP2 | TestPoint:TestPoint_Pad_1.5x1.5mm
GND | TP3 | TestPoint:TestPoint_Pad_1.5x1.5mm
GP46 | TP4 | TestPoint:TestPoint_Pad_1.5x1.5mm
GP47 | TP5 | TestPoint:TestPoint_Pad_1.5x1.5mm
74LVC245APW | U1-U4 | Package_SO:TSSOP-20_4.4x6.5mm_P0.65mm | C6082
74LVC1G06 | U5,U6 | Package_TO_SOT_SMD:SOT-353_SC-70-5 | C7828
74LVC2G34 | U7 | Package_TO_SOT_SMD:SOT-363_SC-70-6 | C14461
CY62167EV30LL-45ZXIT | U10,U11 | Package_SO:TSOP-I-48_18.4x12mm_P0.5mm | C511152
SN74LVC1G32DBVR | U12 | Package_TO_SOT_SMD:SOT-23-5 | C10096
RP2350B | U20 | Package_DFN_QFN:QFN-80-1EP_10x10mm_P0.4mm_EP3.4x3.4mm | C42415655
GD25Q128ESIGR | U21 | Package_SO:SOIC-8_5.3x5.3mm_P1.27mm | C2928891
ME6211C12M5G-N | U23 | Package_TO_SOT_SMD:SOT-23-5 | C236672
TLV1117LV33 | U30 | Package_TO_SOT_SMD:SOT-223-3_TabPin2 | C15578
TPS3839G33 | U31 | Package_TO_SOT_SMD:SOT-23 | C485802
LM66200 | U32 | Package_TO_SOT_SMD:SOT-583-8 | C3235556
12MHz | Y1 | Crystal:Crystal_SMD_3225-4Pin_3.2x2.5mm | C20625731
