timex-sinclair-projects/TS-2068-Megabank/hardware/megabank.kicad_pcb

## KiCad design hardware/megabank.kicad_pcb (2026-11-07)

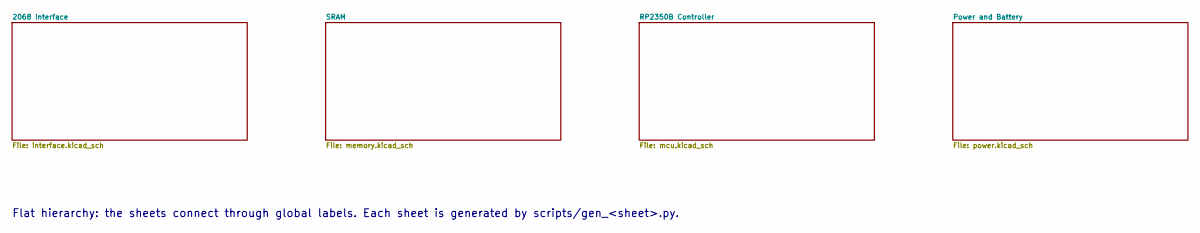
[picture p3: schematic megabank.kicad_sch, TS-2068 Megabank]

Notes on the sheet:
Flat hierarchy: the sheets connect through global labels. Each sheet is generated by scripts/gen_<sheet>.py.

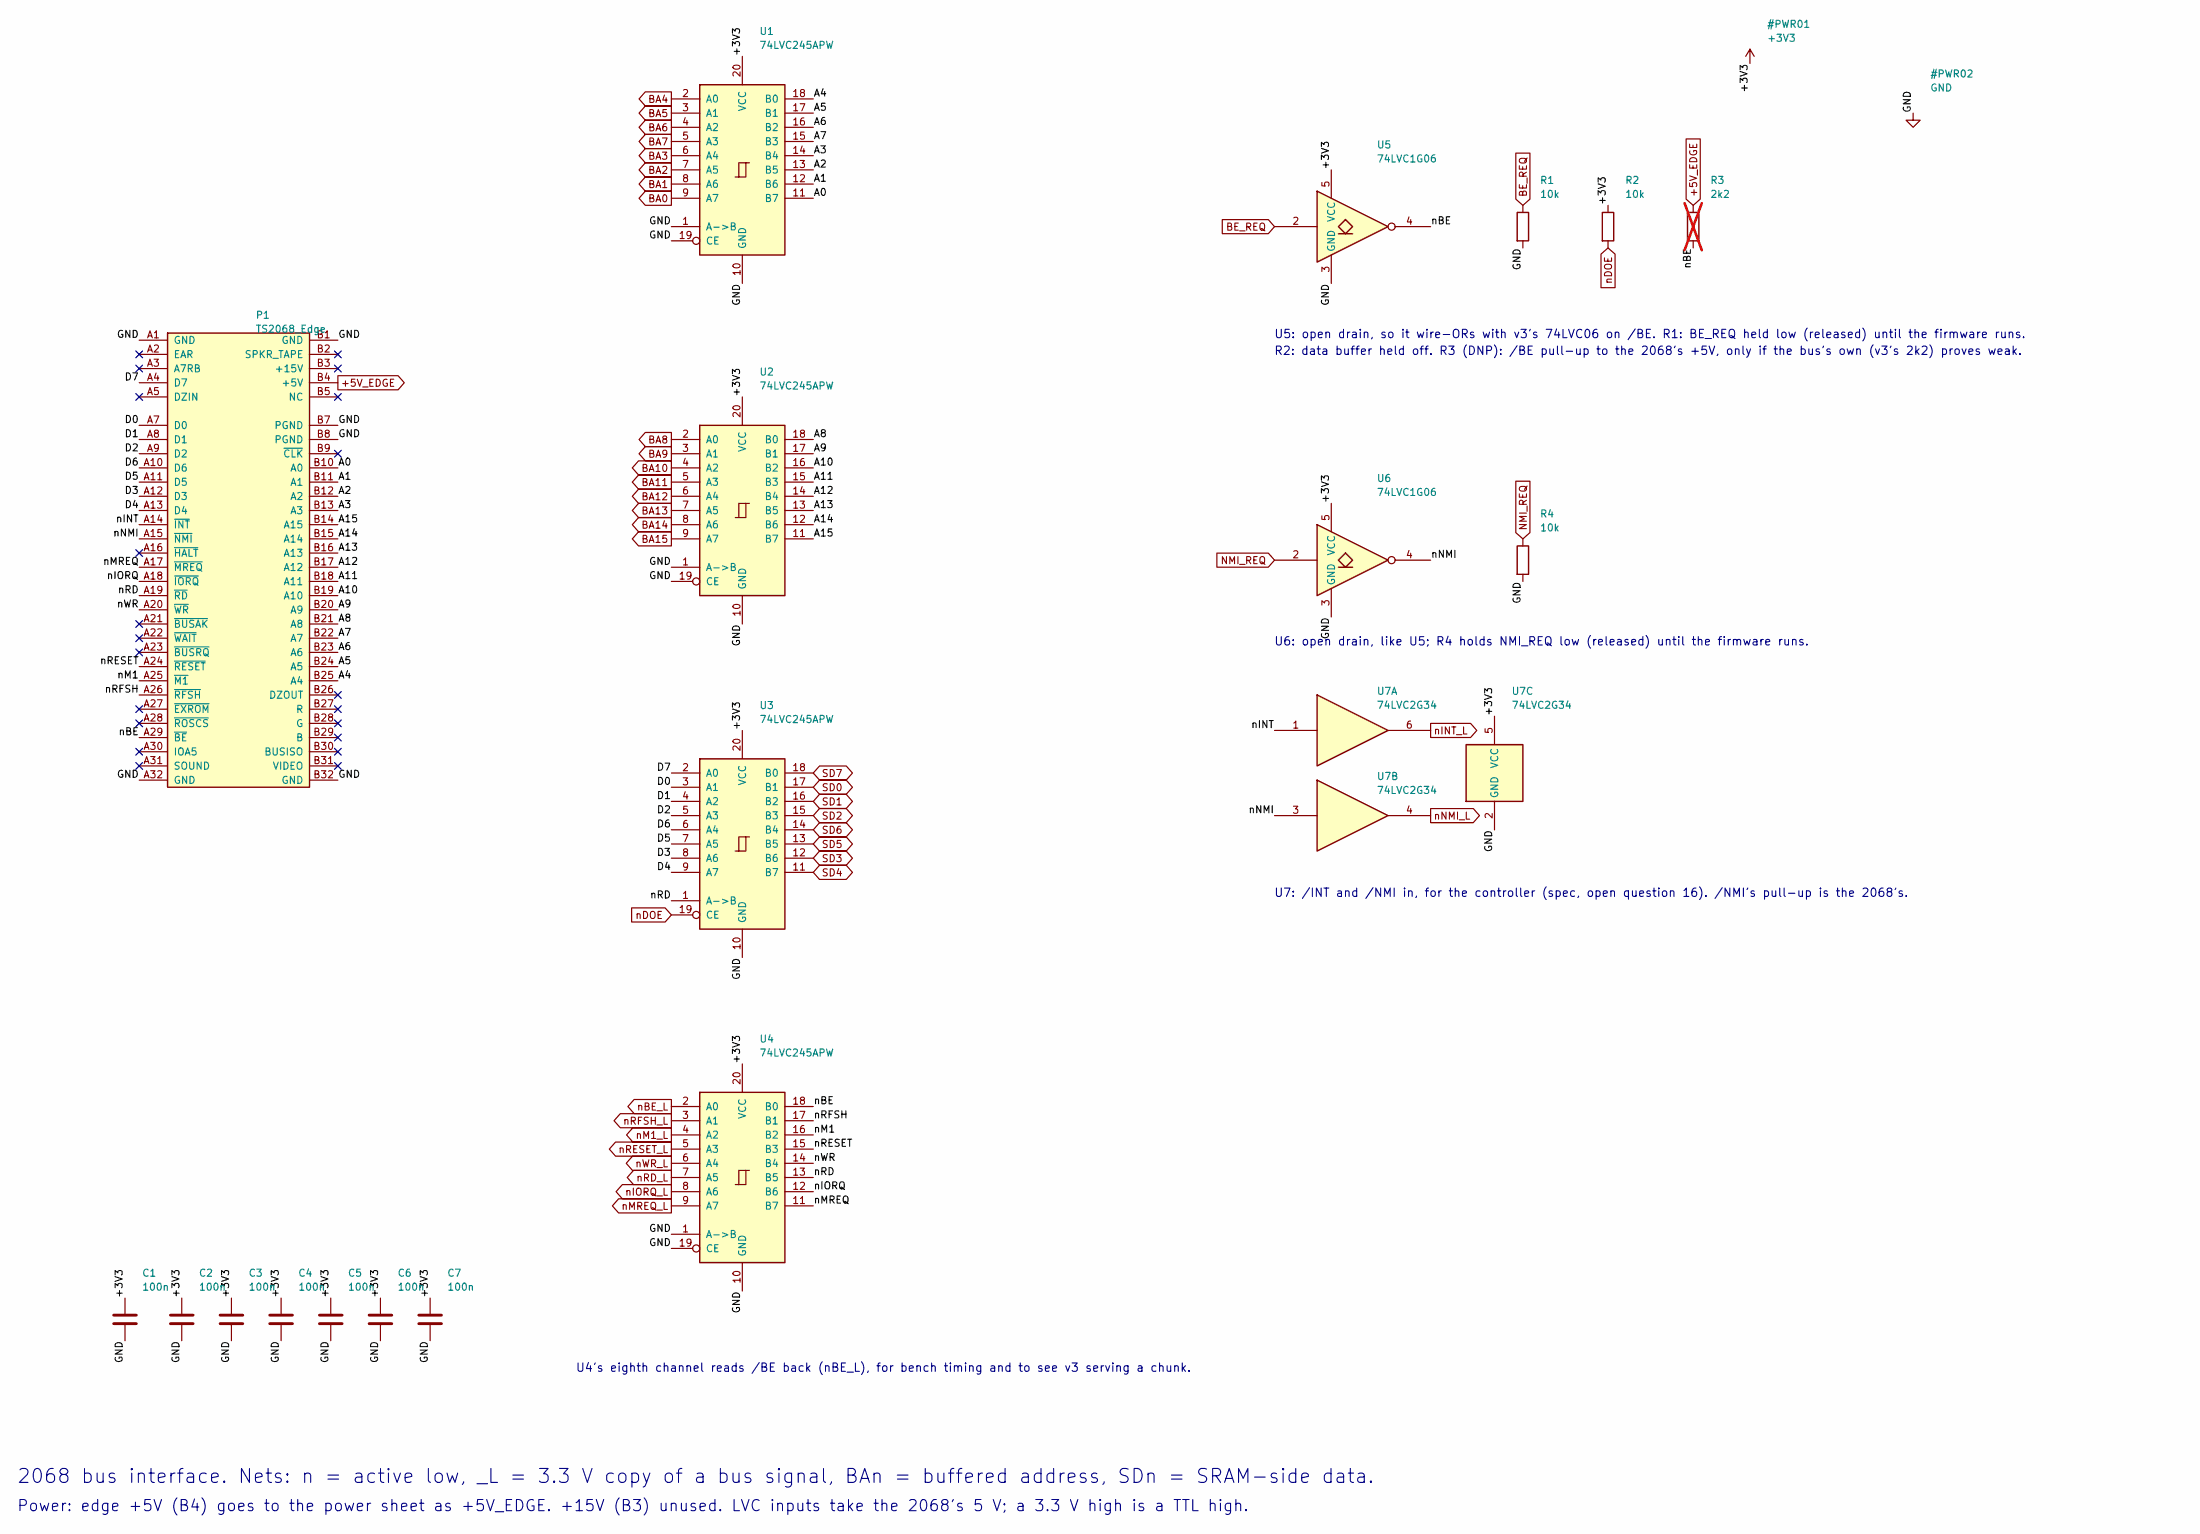
[picture p4: schematic interface.kicad_sch, Megabank: 2068 Interface]

Parts:
C1, C2, C3, C4, C5, C6, C7: 100n; C_0603_1608Metric; MPN CC0603KRX7R9BB104; LCSC C14663
P1: TS2068_Edge; TS2068_EdgeConnector_2x32
R1, R2, R4: 10k; R_0603_1608Metric; MPN 0603WAF1002T5E; LCSC C25804
R3: 2k2; R_0603_1608Metric; MPN 0603WAF2201T5E; LCSC C4190; not fitted
U1, U2, U3, U4: 74LVC245APW; TSSOP-20_4.4x6.5mm_P0.65mm; MPN 74LVC245APW,118; LCSC C6082
U5, U6: 74LVC1G06; SOT-353_SC-70-5; MPN SN74LVC1G06DCKR; LCSC C7828
U7: 74LVC2G34; SOT-363_SC-70-6; MPN SN74LVC2G34DCKR; LCSC C14461

Connections:
+3V3: C1.1, C2.1, C3.1, C4.1, C5.1, C6.1, C7.1, R2.1, U1.20 (VCC), U2.20 (VCC), U3.20 (VCC), U4.20 (VCC), U5.5 (VCC), U6.5 (VCC), U7.5 (VCC); also elsewhere on the board
+5V_EDGE: P1.B4 (+5V), R3.1; also elsewhere on the board
/2068 Interface/A0: P1.B10 (A0), U1.11 (B7)
/2068 Interface/A1: P1.B11 (A1), U1.12 (B6)
/2068 Interface/A2: P1.B12 (A2), U1.13 (B5)
/2068 Interface/A3: P1.B13 (A3), U1.14 (B4)
/2068 Interface/A4: P1.B25 (A4), U1.18 (B0)
/2068 Interface/A5: P1.B24 (A5), U1.17 (B1)
/2068 Interface/A6: P1.B23 (A6), U1.16 (B2)
/2068 Interface/A7: P1.B22 (A7), U1.15 (B3)
/2068 Interface/A8: P1.B21 (A8), U2.18 (B0)
/2068 Interface/A9: P1.B20 (A9), U2.17 (B1)
/2068 Interface/A10: P1.B19 (A10), U2.16 (B2)
/2068 Interface/A11: P1.B18 (A11), U2.15 (B3)
/2068 Interface/A12: P1.B17 (A12), U2.14 (B4)
/2068 Interface/A13: P1.B16 (A13), U2.13 (B5)
/2068 Interface/A14: P1.B15 (A14), U2.12 (B6)
/2068 Interface/A15: P1.B14 (A15), U2.11 (B7)
/2068 Interface/D0: P1.A7 (D0), U3.3 (A1)
/2068 Interface/D1: P1.A8 (D1), U3.4 (A2)
/2068 Interface/D2: P1.A9 (D2), U3.5 (A3)
/2068 Interface/D3: P1.A12 (D3), U3.8 (A6)
/2068 Interface/D4: P1.A13 (D4), U3.9 (A7)
/2068 Interface/D5: P1.A11 (D5), U3.7 (A5)
/2068 Interface/D6: P1.A10 (D6), U3.6 (A4)
/2068 Interface/D7: P1.A4 (D7), U3.2 (A0)
/2068 Interface/nBE: P1.A29 (~BE), R3.2, U4.18 (B0), U5.4
/2068 Interface/nINT: P1.A14 (~INT), U7.1
/2068 Interface/nIORQ: P1.A18 (~IORQ), U4.12 (B6)
/2068 Interface/nM1: P1.A25 (~M1), U4.16 (B2)
/2068 Interface/nMREQ: P1.A17 (~MREQ), U4.11 (B7)
/2068 Interface/nNMI: P1.A15 (~NMI), U6.4, U7.3
/2068 Interface/nRD: P1.A19 (~RD), U3.1 (A->B), U4.13 (B5)
/2068 Interface/nRESET: P1.A24 (~RESET), U4.15 (B3)
/2068 Interface/nRFSH: P1.A26 (~RFSH), U4.17 (B1)
/2068 Interface/nWR: P1.A20 (~WR), U4.14 (B4)
BA0: U1.9 (A7); also elsewhere on the board
BA1: U1.8 (A6); also elsewhere on the board
BA2: U1.7 (A5); also elsewhere on the board
BA3: U1.6 (A4); also elsewhere on the board
BA4: U1.2 (A0); also elsewhere on the board
BA5: U1.3 (A1); also elsewhere on the board
BA6: U1.4 (A2); also elsewhere on the board
BA7: U1.5 (A3); also elsewhere on the board
BA8: U2.2 (A0); also elsewhere on the board
BA9: U2.3 (A1); also elsewhere on the board
BA10: U2.4 (A2); also elsewhere on the board
BA11: U2.5 (A3); also elsewhere on the board
BA12: U2.6 (A4); also elsewhere on the board
BA13: U2.7 (A5); also elsewhere on the board
BA14: U2.8 (A6); also elsewhere on the board
BA15: U2.9 (A7); also elsewhere on the board
BE_REQ: R1.1, U5.2; also elsewhere on the board
GND: C1.2, C2.2, C3.2, C4.2, C5.2, C6.2, C7.2, P1.A1 (GND), P1.A32 (GND), P1.B1 (GND), P1.B7 (PGND), P1.B8 (PGND), P1.B32 (GND), R1.2, R4.2, U1.1 (A->B), U1.10 (GND), U1.19 (CE), U2.1 (A->B), U2.10 (GND), U2.19 (CE), U3.10 (GND), U4.1 (A->B), U4.10 (GND), U4.19 (CE), U5.3 (GND), U6.3 (GND), U7.2 (GND); also elsewhere on the board
NMI_REQ: R4.1, U6.2; also elsewhere on the board
SD0: U3.17 (B1); also elsewhere on the board
SD1: U3.16 (B2); also elsewhere on the board
SD2: U3.15 (B3); also elsewhere on the board
SD3: U3.12 (B6); also elsewhere on the board
SD4: U3.11 (B7); also elsewhere on the board
SD5: U3.13 (B5); also elsewhere on the board
SD6: U3.14 (B4); also elsewhere on the board
SD7: U3.18 (B0); also elsewhere on the board
nBE_L: U4.2 (A0); also elsewhere on the board
nDOE: R2.2, U3.19 (CE); also elsewhere on the board
nINT_L: U7.6; also elsewhere on the board
nIORQ_L: U4.8 (A6); also elsewhere on the board
nM1_L: U4.4 (A2); also elsewhere on the board
nMREQ_L: U4.9 (A7); also elsewhere on the board
nNMI_L: U7.4; also elsewhere on the board
nRD_L: U4.7 (A5); also elsewhere on the board
nRESET_L: U4.5 (A3); also elsewhere on the board
nRFSH_L: U4.3 (A1); also elsewhere on the board
nWR_L: U4.6 (A4); also elsewhere on the board

Notes on the sheet:
2068 bus interface. Nets: n = active low, _L = 3.3 V copy of a bus signal, BAn = buffered address, SDn = SRAM-side data.
Power: edge +5V (B4) goes to the power sheet as +5V_EDGE. +15V (B3) unused. LVC inputs take the 2068's 5 V; a 3.3 V high is a TTL high.
U4's eighth channel reads /BE back (nBE_L), for bench timing and to see v3 serving a chunk.
U5: open drain, so it wire-ORs with v3's 74LVC06 on /BE. R1: BE_REQ held low (released) until the firmware runs.
R2: data buffer held off. R3 (DNP): /BE pull-up to the 2068's +5V, only if the bus's own (v3's 2k2) proves weak.
U6: open drain, like U5; R4 holds NMI_REQ low (released) until the firmware runs.
U7: /INT and /NMI in, for the controller (spec, open question 16). /NMI's pull-up is the 2068's.

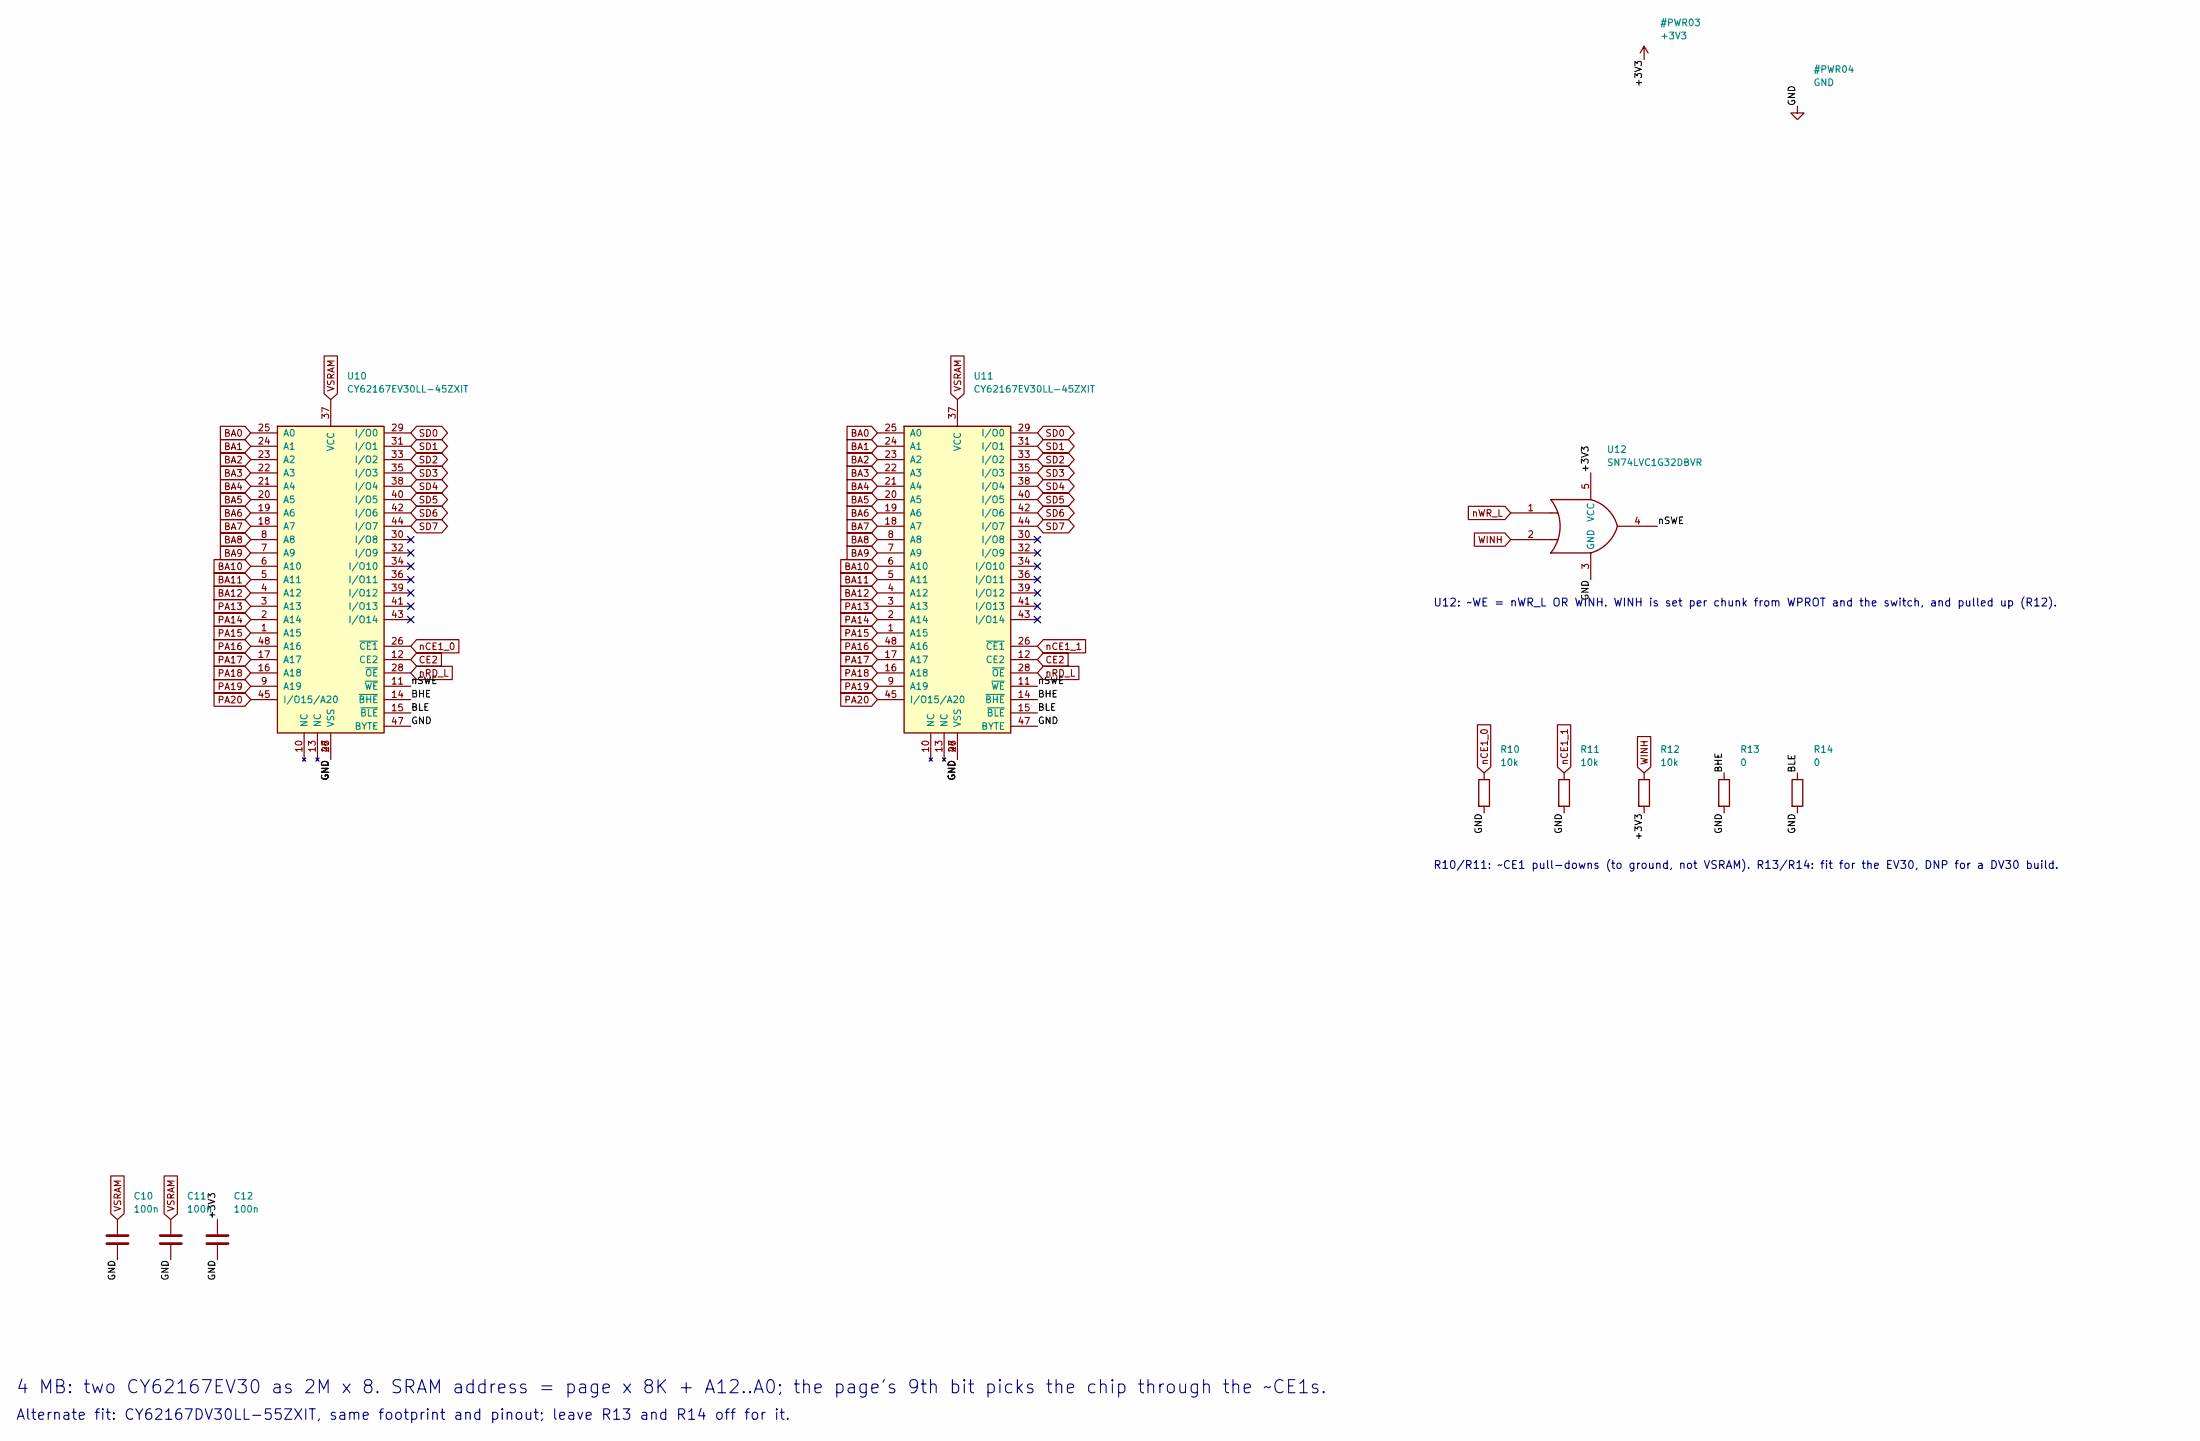
[picture p5: schematic memory.kicad_sch, Megabank: SRAM]

Parts:
C10, C11, C12: 100n; C_0603_1608Metric; MPN CC0603KRX7R9BB104; LCSC C14663
R10, R11, R12: 10k; R_0603_1608Metric; MPN 0603WAF1002T5E; LCSC C25804
R13, R14: 0; R_0603_1608Metric; MPN 0603WAF0000T5E; LCSC C21189
U10, U11: CY62167EV30LL-45ZXIT; TSOP-I-48_18.4x12mm_P0.5mm; MPN CY62167EV30LL-45ZXIT; LCSC C511152
U12: SN74LVC1G32DBVR; SOT-23-5; MPN SN74LVC1G32DBVR; LCSC C10096

Connections:
+3V3: C12.1, R12.2, U12.5 (VCC); also elsewhere on the board
/SRAM/BHE: R13.1, U10.14 (~BHE), U11.14 (~BHE)
/SRAM/BLE: R14.1, U10.15 (~BLE), U11.15 (~BLE)
/SRAM/nSWE: U10.11 (~WE), U11.11 (~WE), U12.4
BA0: U10.25 (A0), U11.25 (A0); also elsewhere on the board
BA1: U10.24 (A1), U11.24 (A1); also elsewhere on the board
BA2: U10.23 (A2), U11.23 (A2); also elsewhere on the board
BA3: U10.22 (A3), U11.22 (A3); also elsewhere on the board
BA4: U10.21 (A4), U11.21 (A4); also elsewhere on the board
BA5: U10.20 (A5), U11.20 (A5); also elsewhere on the board
BA6: U10.19 (A6), U11.19 (A6); also elsewhere on the board
BA7: U10.18 (A7), U11.18 (A7); also elsewhere on the board
BA8: U10.8 (A8), U11.8 (A8); also elsewhere on the board
BA9: U10.7 (A9), U11.7 (A9); also elsewhere on the board
BA10: U10.6 (A10), U11.6 (A10); also elsewhere on the board
BA11: U10.5 (A11), U11.5 (A11); also elsewhere on the board
BA12: U10.4 (A12), U11.4 (A12); also elsewhere on the board
CE2: U10.12 (CE2), U11.12 (CE2); also elsewhere on the board
GND: C10.2, C11.2, C12.2, R10.2, R11.2, R13.2, R14.2, U10.27 (VSS), U10.46 (VSS), U10.47 (BYTE), U11.27 (VSS), U11.46 (VSS), U11.47 (BYTE), U12.3 (GND); also elsewhere on the board
PA13: U10.3 (A13), U11.3 (A13); also elsewhere on the board
PA14: U10.2 (A14), U11.2 (A14); also elsewhere on the board
PA15: U10.1 (A15), U11.1 (A15); also elsewhere on the board
PA16: U10.48 (A16), U11.48 (A16); also elsewhere on the board
PA17: U10.17 (A17), U11.17 (A17); also elsewhere on the board
PA18: U10.16 (A18), U11.16 (A18); also elsewhere on the board
PA19: U10.9 (A19), U11.9 (A19); also elsewhere on the board
PA20: U10.45 (I/O15/A20), U11.45 (I/O15/A20); also elsewhere on the board
SD0: U10.29 (I/O0), U11.29 (I/O0); also elsewhere on the board
SD1: U10.31 (I/O1), U11.31 (I/O1); also elsewhere on the board
SD2: U10.33 (I/O2), U11.33 (I/O2); also elsewhere on the board
SD3: U10.35 (I/O3), U11.35 (I/O3); also elsewhere on the board
SD4: U10.38 (I/O4), U11.38 (I/O4); also elsewhere on the board
SD5: U10.40 (I/O5), U11.40 (I/O5); also elsewhere on the board
SD6: U10.42 (I/O6), U11.42 (I/O6); also elsewhere on the board
SD7: U10.44 (I/O7), U11.44 (I/O7); also elsewhere on the board
VSRAM: C10.1, C11.1, U10.37 (VCC), U11.37 (VCC); also elsewhere on the board
WINH: R12.1, U12.2; also elsewhere on the board
nCE1_0: R10.1, U10.26 (~CE1); also elsewhere on the board
nCE1_1: R11.1, U11.26 (~CE1); also elsewhere on the board
nRD_L: U10.28 (~OE), U11.28 (~OE); also elsewhere on the board
nWR_L: U12.1; also elsewhere on the board

Notes on the sheet:
4 MB: two CY62167EV30 as 2M x 8. SRAM address = page x 8K + A12..A0; the page's 9th bit picks the chip through the ~CE1s.
Alternate fit: CY62167DV30LL-55ZXIT, same footprint and pinout; leave R13 and R14 off for it.
U12: ~WE = nWR_L OR WINH. WINH is set per chunk from WPROT and the switch, and pulled up (R12).
R10/R11: ~CE1 pull-downs (to ground, not VSRAM). R13/R14: fit for the EV30, DNP for a DV30 build.

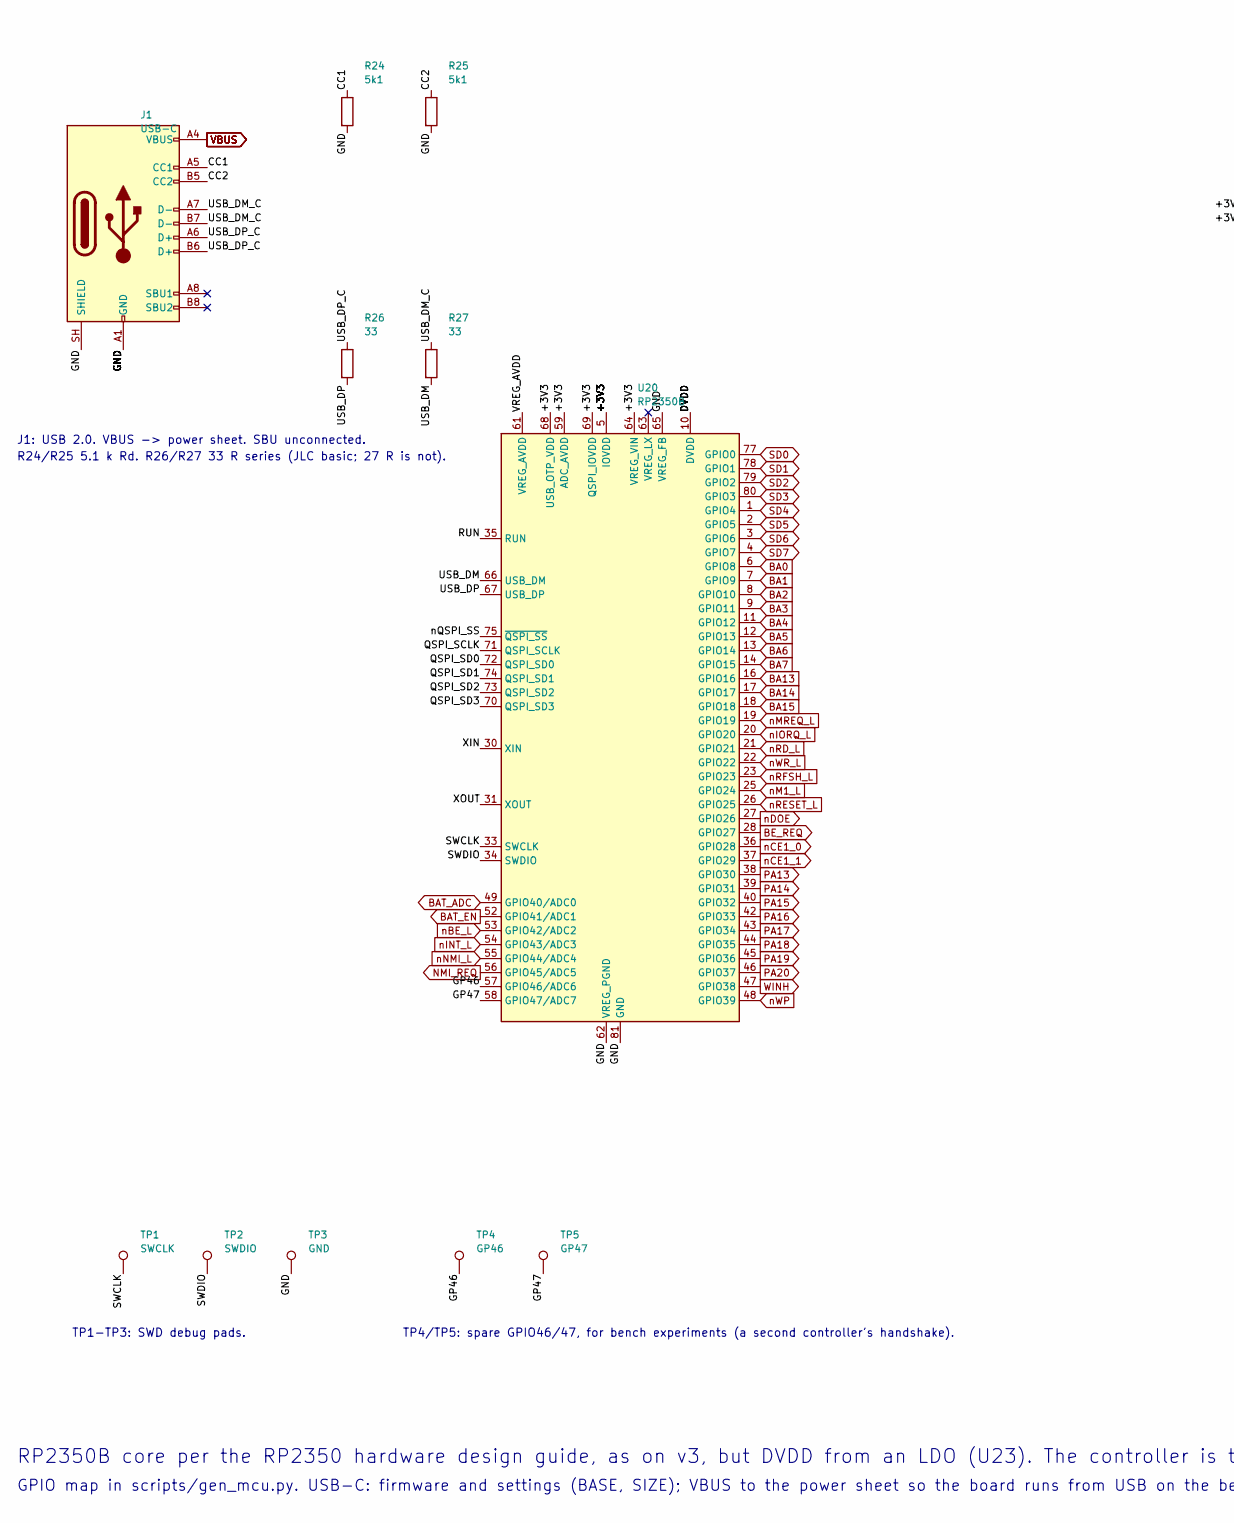
[picture p6: schematic mcu.kicad_sch, Megabank: RP2350B Controller, part in row 1, column 1]

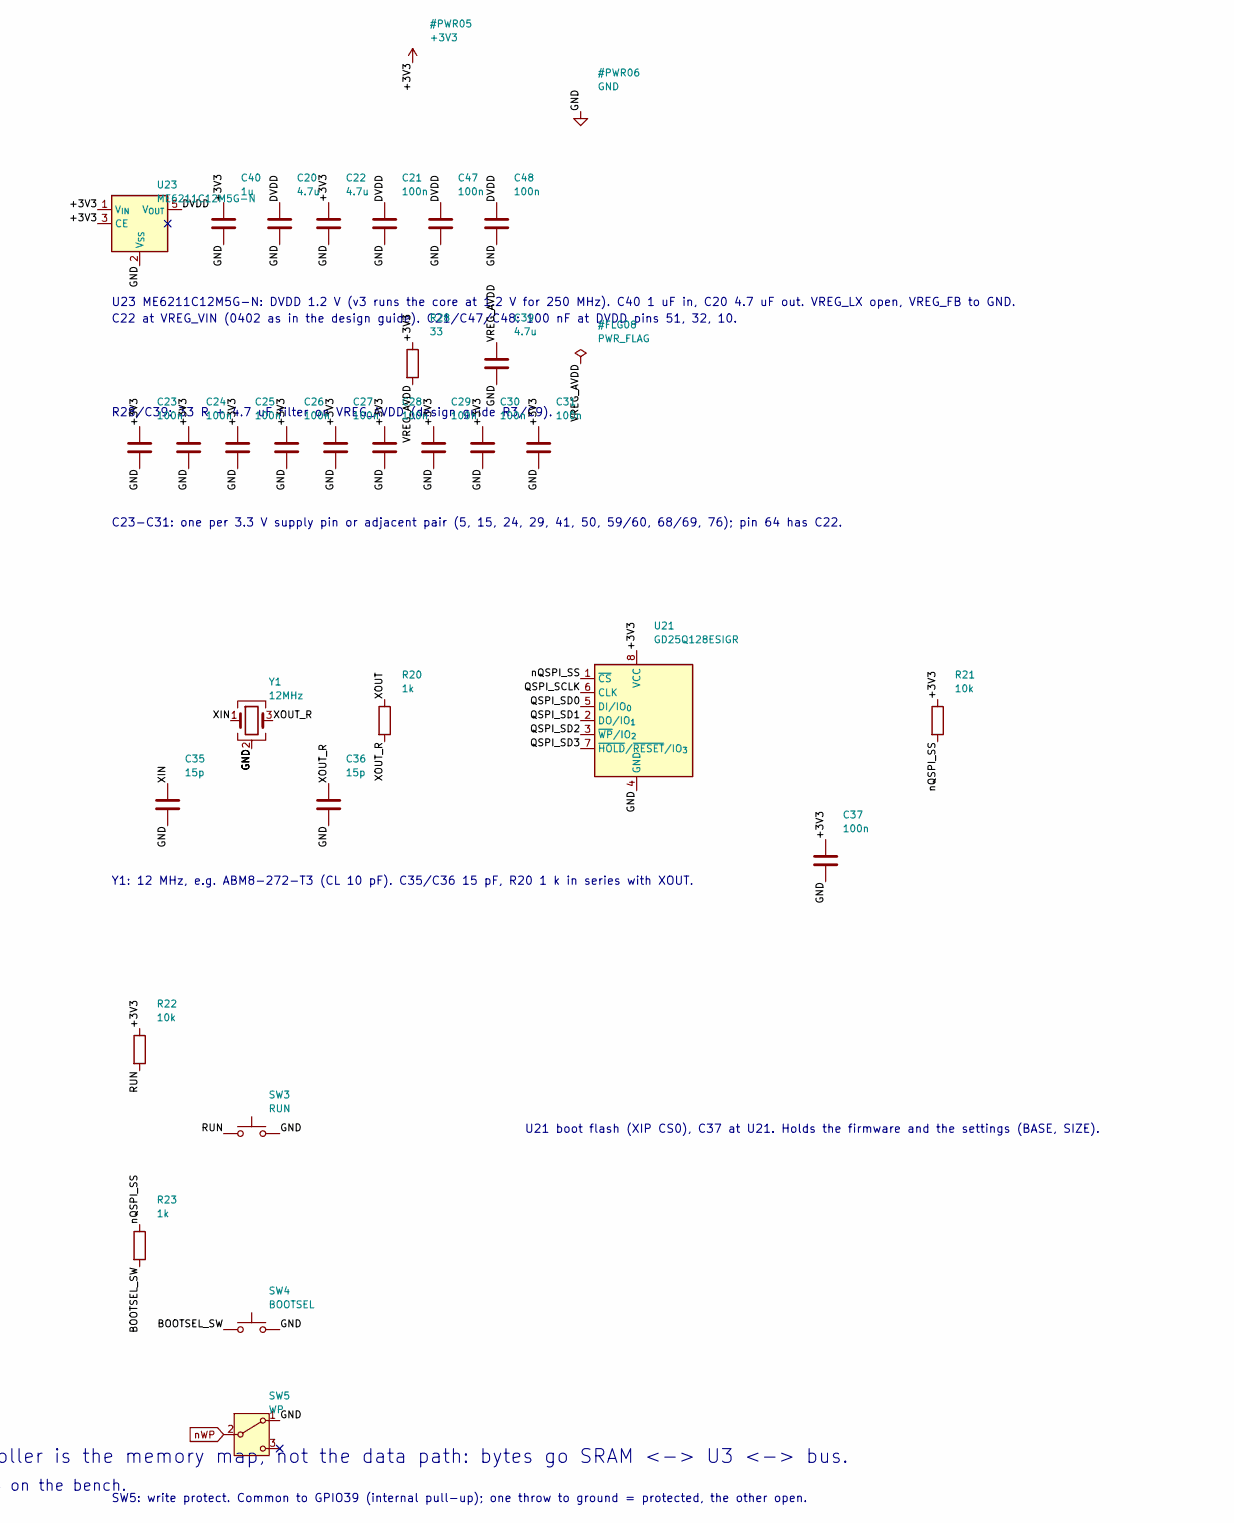
[picture p7: schematic mcu.kicad_sch, Megabank: RP2350B Controller, part in row 1, column 2]

Parts:
C20, C22, C39: 4.7u; C_0402_1005Metric; MPN CL05A475MP5NRNC; LCSC C23733
C21, C23, C24, C25, C26, C27, C28, C29, C30, C31, C37, C47, C48: 100n; C_0603_1608Metric; MPN CC0603KRX7R9BB104; LCSC C14663
C35, C36: 15p; C_0603_1608Metric; MPN CL10C150JB8NNNC; LCSC C1644
C40: 1u; C_0603_1608Metric; MPN CL10A105KB8NNNC; LCSC C15849
J1: USB-C; USB_C_Receptacle_HRO_TYPE-C-31-M-12; MPN TYPE-C-31-M-12; LCSC C165948
R20, R23: 1k; R_0603_1608Metric; MPN 0603WAF1001T5E; LCSC C21190
R21, R22: 10k; R_0603_1608Metric; MPN 0603WAF1002T5E; LCSC C25804
R24, R25: 5k1; R_0603_1608Metric; MPN 0603WAF5101T5E; LCSC C23186
R26, R27, R28: 33; R_0603_1608Metric; MPN 0603WAF330JT5E; LCSC C23140
SW3: RUN; SW_Push_1P1T_XKB_TS-1187A; MPN TS-1187A-B-A-B; LCSC C318884
SW4: BOOTSEL; SW_Push_1P1T_XKB_TS-1187A; MPN TS-1187A-B-A-B; LCSC C318884
SW5: WP; SW_SPDT_Shouhan_MSK12C02; MPN MSK12C02; LCSC C431540
TP1: SWCLK; TestPoint_Pad_1.5x1.5mm
TP2: SWDIO; TestPoint_Pad_1.5x1.5mm
TP3: GND; TestPoint_Pad_1.5x1.5mm
TP4: GP46; TestPoint_Pad_1.5x1.5mm
TP5: GP47; TestPoint_Pad_1.5x1.5mm
U20: RP2350B; QFN-80-1EP_10x10mm_P0.4mm_EP3.4x3.4mm; MPN RP2350B; LCSC C42415655
U21: GD25Q128ESIGR; SOIC-8_5.3x5.3mm_P1.27mm; MPN GD25Q128ESIGR; LCSC C2928891
U23: ME6211C12M5G-N; SOT-23-5; MPN ME6211C12M5G-N; LCSC C236672
Y1: 12MHz; Crystal_SMD_3225-4Pin_3.2x2.5mm; MPN ABM8-272-T3; LCSC C20625731

Connections:
+3V3: C22.1, C23.1, C24.1, C25.1, C26.1, C27.1, C28.1, C29.1, C30.1, C31.1, C37.1, C40.1, R21.1, R22.1, R28.1, U20.5 (IOVDD), U20.15 (IOVDD), U20.24 (IOVDD), U20.29 (IOVDD), U20.41 (IOVDD), U20.50 (IOVDD), U20.59 (ADC_AVDD), U20.60 (IOVDD), U20.64 (VREG_VIN), U20.68 (USB_OTP_VDD), U20.69 (QSPI_IOVDD), U20.76 (IOVDD), U21.8 (VCC), U23.1 (V_{IN}), U23.3 (CE); also elsewhere on the board
/RP2350B Controller/BOOTSEL_SW: R23.2, SW4.1
/RP2350B Controller/CC1: J1.A5 (CC1), R24.1
/RP2350B Controller/CC2: J1.B5 (CC2), R25.1
/RP2350B Controller/DVDD: C20.1, C21.1, C47.1, C48.1, U20.10 (DVDD), U20.32 (DVDD), U20.51 (DVDD), U23.5 (V_{OUT})
/RP2350B Controller/GP46: TP4.1, U20.57 (GPIO46/ADC6)
/RP2350B Controller/GP47: TP5.1, U20.58 (GPIO47/ADC7)
/RP2350B Controller/QSPI_SCLK: U20.71 (QSPI_SCLK), U21.6 (CLK)
/RP2350B Controller/QSPI_SD0: U20.72 (QSPI_SD0), U21.5 (DI/IO_{0})
/RP2350B Controller/QSPI_SD1: U20.74 (QSPI_SD1), U21.2 (DO/IO_{1})
/RP2350B Controller/QSPI_SD2: U20.73 (QSPI_SD2), U21.3 (~WP/IO_{2})
/RP2350B Controller/QSPI_SD3: U20.70 (QSPI_SD3), U21.7 (~HOLD/~RESET/IO_{3})
/RP2350B Controller/RUN: R22.2, SW3.1, U20.35 (RUN)
/RP2350B Controller/SWCLK: TP1.1, U20.33 (SWCLK)
/RP2350B Controller/SWDIO: TP2.1, U20.34 (SWDIO)
/RP2350B Controller/USB_DM: R27.2, U20.66 (USB_DM)
/RP2350B Controller/USB_DM_C: J1.A7 (D-), J1.B7 (D-), R27.1
/RP2350B Controller/USB_DP: R26.2, U20.67 (USB_DP)
/RP2350B Controller/USB_DP_C: J1.A6 (D+), J1.B6 (D+), R26.1
/RP2350B Controller/VREG_AVDD: C39.1, R28.2, U20.61 (VREG_AVDD)
/RP2350B Controller/XIN: C35.1, U20.30 (XIN), Y1.1
/RP2350B Controller/XOUT: R20.1, U20.31 (XOUT)
/RP2350B Controller/XOUT_R: C36.1, R20.2, Y1.3
/RP2350B Controller/nQSPI_SS: R21.2, R23.1, U20.75 (~QSPI_SS), U21.1 (~CS)
BA0: U20.6 (GPIO8); also elsewhere on the board
BA1: U20.7 (GPIO9); also elsewhere on the board
BA2: U20.8 (GPIO10); also elsewhere on the board
BA3: U20.9 (GPIO11); also elsewhere on the board
BA4: U20.11 (GPIO12); also elsewhere on the board
BA5: U20.12 (GPIO13); also elsewhere on the board
BA6: U20.13 (GPIO14); also elsewhere on the board
BA7: U20.14 (GPIO15); also elsewhere on the board
BA13: U20.16 (GPIO16); also elsewhere on the board
BA14: U20.17 (GPIO17); also elsewhere on the board
BA15: U20.18 (GPIO18); also elsewhere on the board
BAT_ADC: U20.49 (GPIO40/ADC0); also elsewhere on the board
BAT_EN: U20.52 (GPIO41/ADC1); also elsewhere on the board
BE_REQ: U20.28 (GPIO27); also elsewhere on the board
GND: C20.2, C21.2, C22.2, C23.2, C24.2, C25.2, C26.2, C27.2, C28.2, C29.2, C30.2, C31.2, C35.2, C36.2, C37.2, C39.2, C40.2, C47.2, C48.2, J1.A1 (GND), J1.A12 (GND), J1.B1 (GND), J1.B12 (GND), J1.SH (SHIELD), R24.2, R25.2, SW3.2, SW4.2, SW5.1 (A), TP3.1, U20.62 (VREG_PGND), U20.65 (VREG_FB), U20.81 (GND), U21.4 (GND), U23.2 (V_{SS}), Y1.2 (G), Y1.4 (G); also elsewhere on the board
NMI_REQ: U20.56 (GPIO45/ADC5); also elsewhere on the board
PA13: U20.38 (GPIO30); also elsewhere on the board
PA14: U20.39 (GPIO31); also elsewhere on the board
PA15: U20.40 (GPIO32); also elsewhere on the board
PA16: U20.42 (GPIO33); also elsewhere on the board
PA17: U20.43 (GPIO34); also elsewhere on the board
PA18: U20.44 (GPIO35); also elsewhere on the board
PA19: U20.45 (GPIO36); also elsewhere on the board
PA20: U20.46 (GPIO37); also elsewhere on the board
SD0: U20.77 (GPIO0); also elsewhere on the board
SD1: U20.78 (GPIO1); also elsewhere on the board
SD2: U20.79 (GPIO2); also elsewhere on the board
SD3: U20.80 (GPIO3); also elsewhere on the board
SD4: U20.1 (GPIO4); also elsewhere on the board
SD5: U20.2 (GPIO5); also elsewhere on the board
SD6: U20.3 (GPIO6); also elsewhere on the board
SD7: U20.4 (GPIO7); also elsewhere on the board
VBUS: J1.A4 (VBUS), J1.A9 (VBUS), J1.B4 (VBUS), J1.B9 (VBUS); also elsewhere on the board
WINH: U20.47 (GPIO38); also elsewhere on the board
nBE_L: U20.53 (GPIO42/ADC2); also elsewhere on the board
nCE1_0: U20.36 (GPIO28); also elsewhere on the board
nCE1_1: U20.37 (GPIO29); also elsewhere on the board
nDOE: U20.27 (GPIO26); also elsewhere on the board
nINT_L: U20.54 (GPIO43/ADC3); also elsewhere on the board
nIORQ_L: U20.20 (GPIO20); also elsewhere on the board
nM1_L: U20.25 (GPIO24); also elsewhere on the board
nMREQ_L: U20.19 (GPIO19); also elsewhere on the board
nNMI_L: U20.55 (GPIO44/ADC4); also elsewhere on the board
nRD_L: U20.21 (GPIO21); also elsewhere on the board
nRESET_L: U20.26 (GPIO25); also elsewhere on the board
nRFSH_L: U20.23 (GPIO23); also elsewhere on the board
nWP: SW5.2 (B), U20.48 (GPIO39)
nWR_L: U20.22 (GPIO22); also elsewhere on the board

Notes on the sheet:
RP2350B core per the RP2350 hardware design guide, as on v3, but DVDD from an LDO (U23). The controller is the memory map, not the data path: bytes go SRAM <-> U3 <-> bus.
GPIO map in scripts/gen_mcu.py. USB-C: firmware and settings (BASE, SIZE); VBUS to the power sheet so the board runs from USB on the bench.
U23 ME6211C12M5G-N: DVDD 1.2 V (v3 runs the core at 1.2 V for 250 MHz). C40 1 uF in, C20 4.7 uF out. VREG_LX open, VREG_FB to GND.
C22 at VREG_VIN (0402 as in the design guide). C21/C47/C48: 100 nF at DVDD pins 51, 32, 10.
R28/C39: 33 R + 4.7 uF filter on VREG_AVDD (design guide R3/C9).
C23-C31: one per 3.3 V supply pin or adjacent pair (5, 15, 24, 29, 41, 50, 59/60, 68/69, 76); pin 64 has C22.
Y1: 12 MHz, e.g. ABM8-272-T3 (CL 10 pF). C35/C36 15 pF, R20 1 k in series with XOUT.
U21 boot flash (XIP CS0), C37 at U21. Holds the firmware and the settings (BASE, SIZE).
J1: USB 2.0. VBUS -> power sheet. SBU unconnected.
R24/R25 5.1 k Rd. R26/R27 33 R series (JLC basic; 27 R is not).
SW5: write protect. Common to GPIO39 (internal pull-up); one throw to ground = protected, the other open.
TP1-TP3: SWD debug pads.
TP4/TP5: spare GPIO46/47, for bench experiments (a second controller's handshake).
