timex-sinclair-projects/TS-2068-Megabank/hardware/megabank.kicad_pcb

## KiCad design hardware/megabank.kicad_pcb (continued)

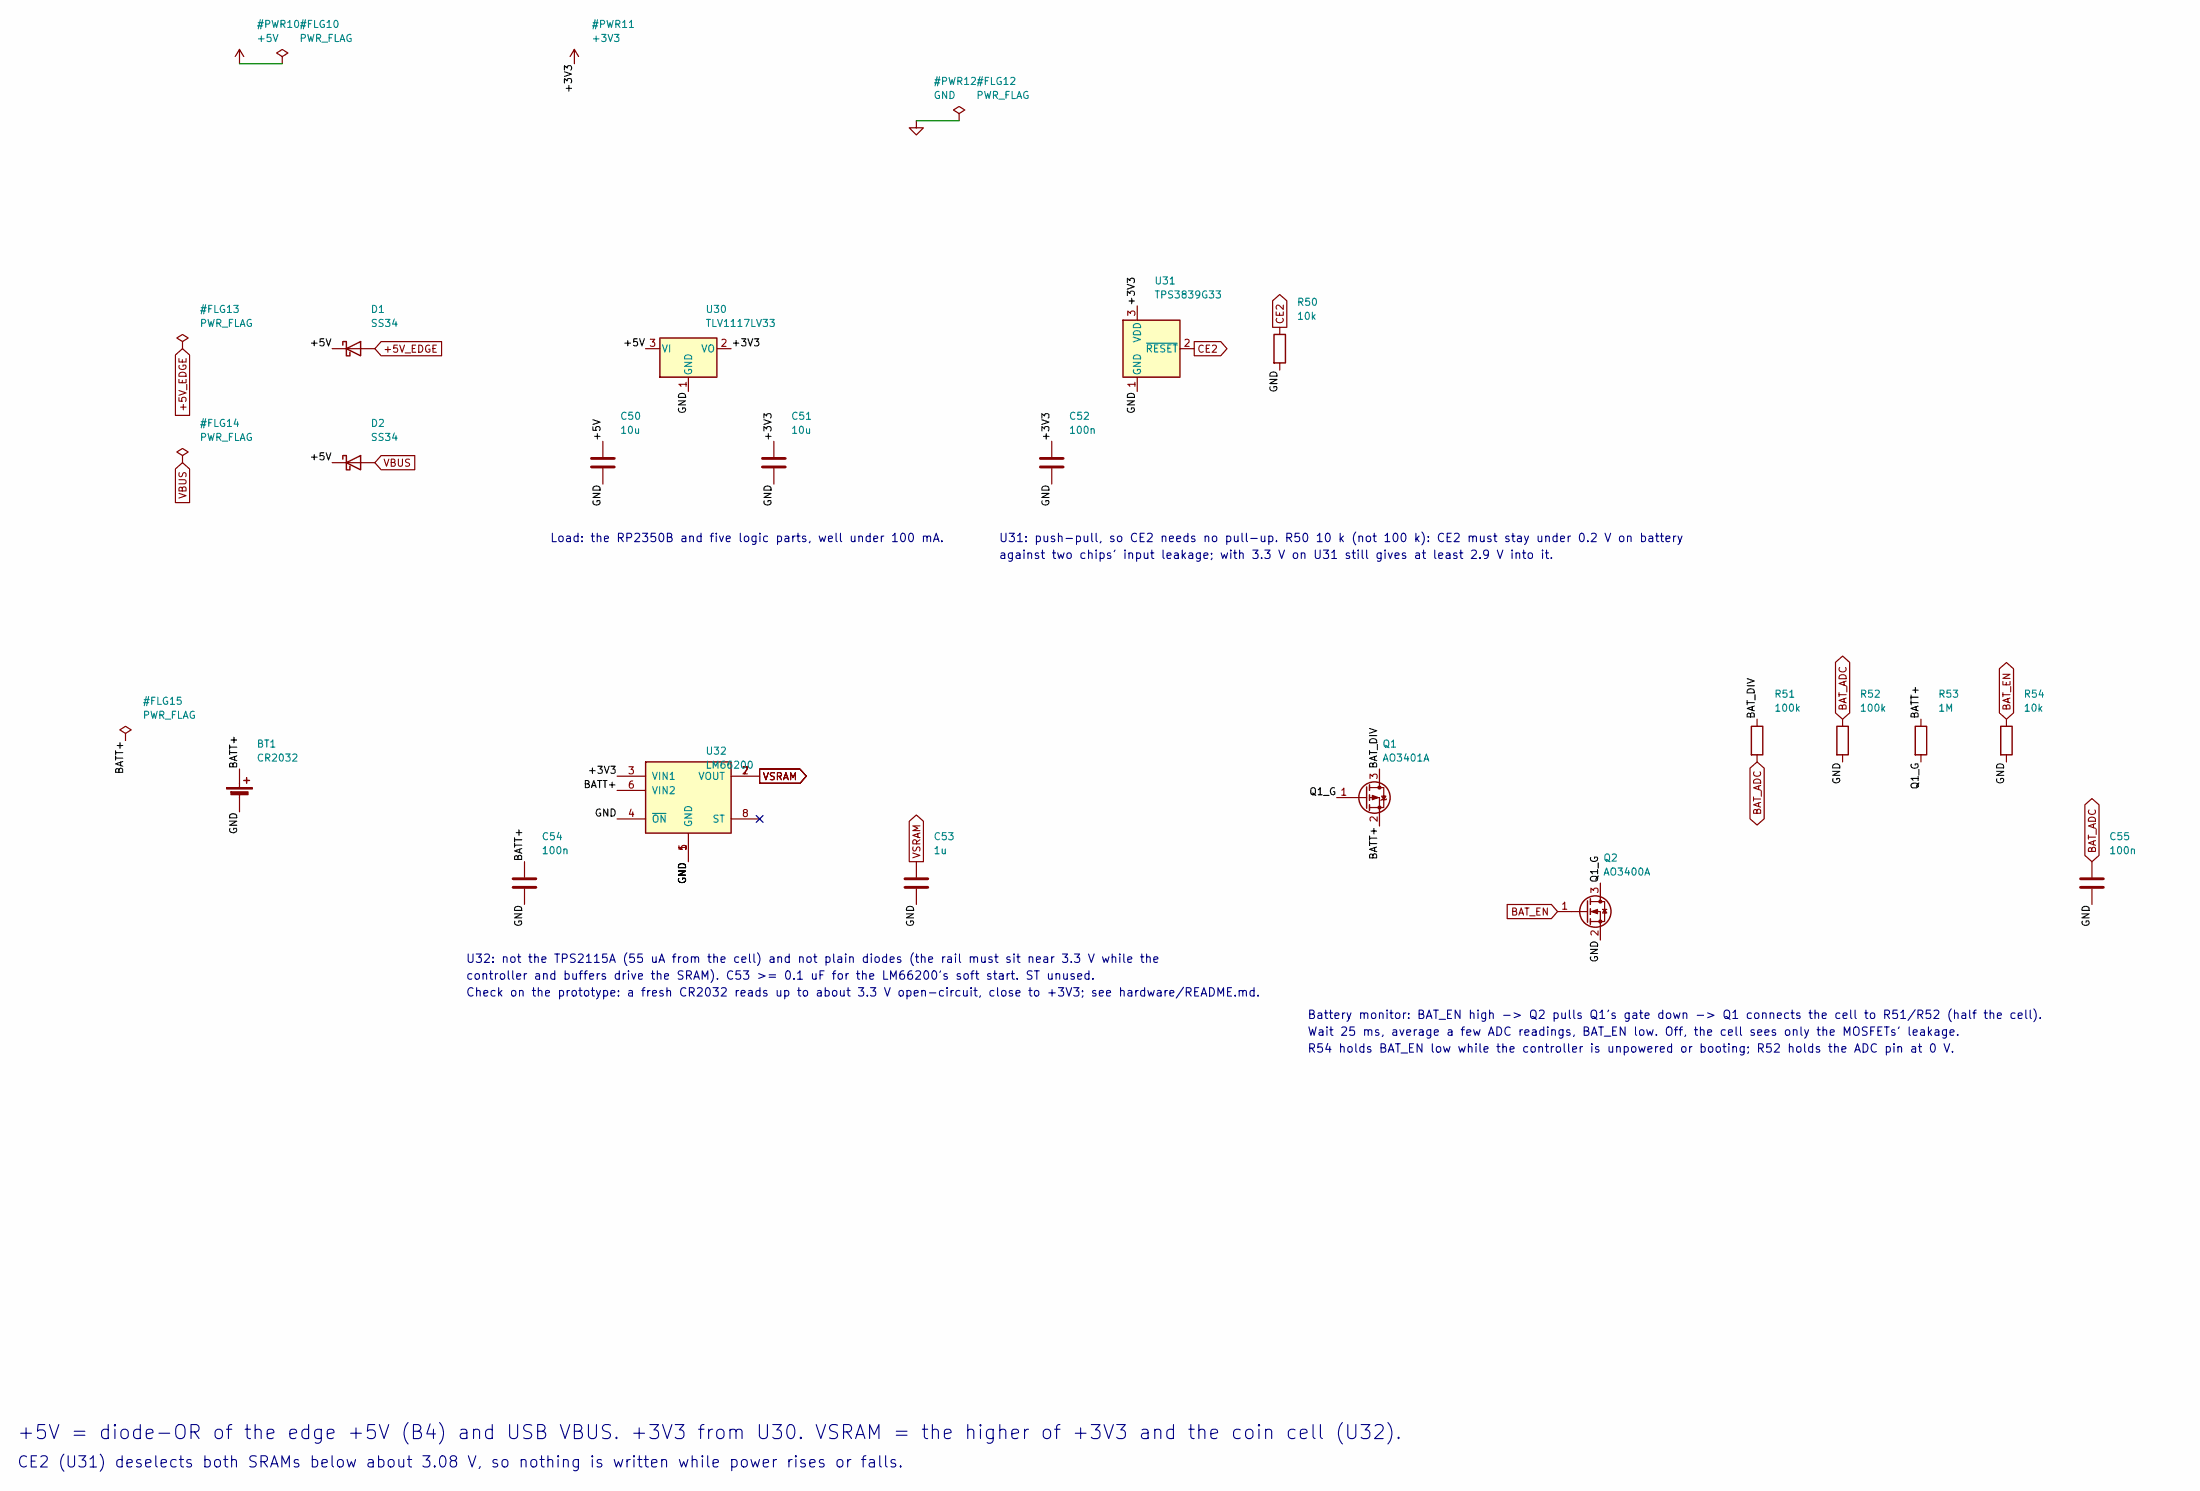
[picture p8: schematic power.kicad_sch, Megabank: Power and Battery]

Parts:
BT1: CR2032; BatteryHolder_Keystone_3034_1x20mm; MPN CR2032-BS-6-1; LCSC C70377
C50, C51: 10u; C_0603_1608Metric; MPN CL10A106KP8NNNC; LCSC C19702
C52, C54, C55: 100n; C_0603_1608Metric; MPN CC0603KRX7R9BB104; LCSC C14663
C53: 1u; C_0603_1608Metric; MPN CL10A105KB8NNNC; LCSC C15849
D1, D2: SS34; D_SMA; MPN SS34; LCSC C8678
Q1: AO3401A; SOT-23; MPN AO3401A; LCSC C15127
Q2: AO3400A; SOT-23; MPN AO3400A; LCSC C20917
R50, R54: 10k; R_0603_1608Metric; MPN 0603WAF1002T5E; LCSC C25804
R51, R52: 100k; R_0603_1608Metric; MPN 0603WAF1003T5E; LCSC C25803
R53: 1M; R_0603_1608Metric; MPN 0603WAF1004T5E; LCSC C22935
U30: TLV1117LV33; SOT-223-3_TabPin2; MPN TLV1117LV33DCYR; LCSC C15578
U31: TPS3839G33; SOT-23; MPN TPS3839G33DBZR; LCSC C485802
U32: LM66200; SOT-583-8; MPN LM66200DRLR; LCSC C3235556

Connections:
+3V3: C51.1, C52.1, U30.2 (VO), U31.3 (VDD), U32.3 (VIN1); also elsewhere on the board
+5V: C50.1, D1.1 (K), D2.1 (K), U30.3 (VI)
+5V_EDGE: D1.2 (A); also elsewhere on the board
/Power and Battery/BATT+: BT1.1 (+), C54.1, Q1.2 (S), R53.1, U32.6 (VIN2)
/Power and Battery/BAT_DIV: Q1.3 (D), R51.1
/Power and Battery/Q1_G: Q1.1 (G), Q2.3 (D), R53.2
BAT_ADC: C55.1, R51.2, R52.1; also elsewhere on the board
BAT_EN: Q2.1 (G), R54.1; also elsewhere on the board
CE2: R50.1, U31.2 (~RESET); also elsewhere on the board
GND: BT1.2 (-), C50.2, C51.2, C52.2, C53.2, C54.2, C55.2, Q2.2 (S), R50.2, R52.2, R54.2, U30.1 (GND), U31.1 (GND), U32.1 (GND), U32.4 (~ON), U32.5 (GND); also elsewhere on the board
VBUS: D2.2 (A); also elsewhere on the board
VSRAM: C53.1, U32.2 (VOUT), U32.7 (VOUT); also elsewhere on the board

Notes on the sheet:
+5V = diode-OR of the edge +5V (B4) and USB VBUS. +3V3 from U30. VSRAM = the higher of +3V3 and the coin cell (U32).
CE2 (U31) deselects both SRAMs below about 3.08 V, so nothing is written while power rises or falls.
Load: the RP2350B and five logic parts, well under 100 mA.
U31: push-pull, so CE2 needs no pull-up. R50 10 k (not 100 k): CE2 must stay under 0.2 V on battery
against two chips' input leakage; with 3.3 V on U31 still gives at least 2.9 V into it.
U32: not the TPS2115A (55 uA from the cell) and not plain diodes (the rail must sit near 3.3 V while the
controller and buffers drive the SRAM). C53 >= 0.1 uF for the LM66200's soft start. ST unused.
Check on the prototype: a fresh CR2032 reads up to about 3.3 V open-circuit, close to +3V3; see hardware/README.md.
Battery monitor: BAT_EN high -> Q2 pulls Q1's gate down -> Q1 connects the cell to R51/R52 (half the cell).
Wait 25 ms, average a few ADC readings, BAT_EN low. Off, the cell sees only the MOSFETs' leakage.
R54 holds BAT_EN low while the controller is unpowered or booting; R52 holds the ADC pin at 0 V.

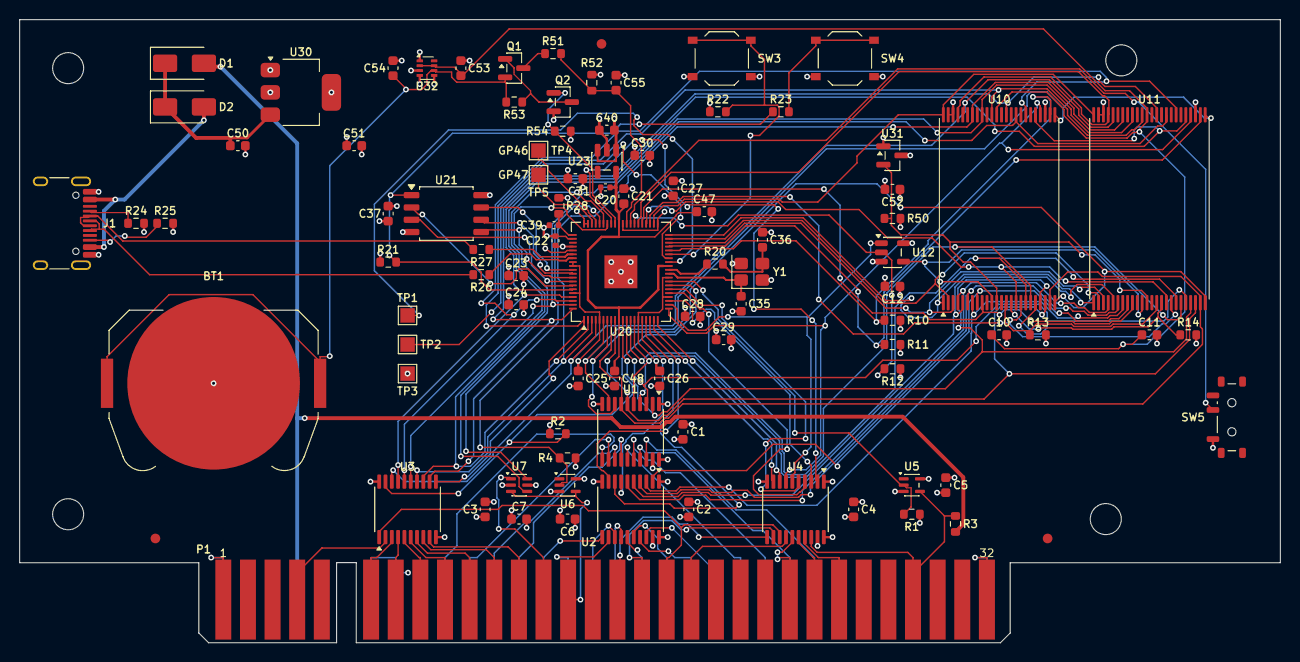
[picture p9: board megabank.kicad_pcb from above]

Board: 4 copper layers, 130.0 x 64.2 mm, 97 parts (0 on the bottom side), 121 nets.

Other parts of the board:
FID1, FID2, FID3: Fiducial_1mm_Mask2mm
H1, H2, H3, H4: MountingHole_3.2mm_M3
