timex-sinclair-projects/TS-2068-Megabank/(commit log)

2026-10-16 Megabank: README and the draft specification
    The design for a battery-backed 4 MB expansion-bank RAM board for the
    TS2068 with the TS-Pico v3, worked out in tspico-firmware-build on
    2026-10-16.
2026-10-16 Spec: RP2350B controller, 3.3 V SRAM, all-SMD JLCPCB build
    Replace the CPLD with an RP2350B acting as the memory map (registers,
    /BE, page bits, enables) while bytes go straight between SRAM and the
    bus through 74LVC245s. /BE reuses the v3 card's proven PIO jump table.
    Rework the parts for JLCPCB assembly, with stock checked 2026-10-16:
    2 x CY62167 (IS62WV51216 fallback), LM66200 power mux (the TPS2115A's
    ~55 uA would drain a coin cell), CR2032/CR2450 SMD holder. BASE and
    SIZE move to flash. Update phases, testing and open questions to match.
    README: the controller firmware is software, under MIT; the hardware
    licence now covers the schematic and PCB.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
2026-10-16 Spec: CY62167EV30 preferred; power-fail protection through CE2
    Both CY62167 datasheets confirm the TSOP-I part works as 2M x 8 with
    BYTE tied low (pin 45 becomes A20). Prefer the EV30: 3 uA max standby
    per chip at 25 C against the DV30's 22 uA, and only the enables need
    logic levels in standby. The DV30 stays as a same-footprint alternate,
    with 0-ohm pads for the one pin difference (BHE/BLE).
    CE2 (active high) deselects the chip whatever CE1 does, so the
    supervisor drives both CE2s with a pull-down to ground, and the
    controller drives each /CE1. That removes the decoder, the SRAM-rail
    gate and the MOSFET. The write-inhibit line is pulled up so writes are
    blocked while the controller boots.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
2026-10-16 Spec: the IS62WV51216 fallback has no CS2 in TSOP-II
    Its datasheet (Rev. B, 2005) shows CS1 only in the 44-pin TSOP-II; CS2
    is on the mini-BGA, which JLCPCB stocks only as the 1.8 V ALL part. The
    fallback's power-fail protection goes through /LB and /UB, gated on the
    SRAM rail, and its standby (25 uA max per chip) cuts coin-cell life to
    months. Preference order: CY62167EV30, DV30, then this.
2026-10-16 Spec: SN74LVC1G32DBVR (C10096) for the /WE gate
    TI part in SOT-23-5, 139,210 in stock at JLCPCB on 2026-10-16. Only
    the pull resistors remain to be picked.
2026-10-16 Spec: pull resistors from JLCPCB basic parts
    Six 10 k (C25804) and two 0 ohm (C21189) 0603 basic parts, as on v3.
    The TPS3839G33 is push-pull, so CE2 needs only the pull-down, sized at
    10 k to keep CE2 under 0.2 V against two chips' leakage. Note the
    supervisor's 200 ms power-on delay. Open question 6 now lists the
    battery monitor's switch instead; new open question 13 asks where the
    bus's /BE pull-up is.
2026-10-16 Spec: battery monitor switch circuit
    A P-channel high-side switch (AO3401A) with an N-channel gate driver
    (AO3400A) connects a 2:1 divider and 100 nF to an ADC pin only while
    the controller measures, so the coin cell never feeds the unpowered
    RP2350B. Netlist, parts (all JLCPCB basic), firmware sequence and the
    STATUS threshold. Removes the item from open question 6.
2026-10-16 Spec: keep the Abracon L1; adopt v3's design flow and gold fingers
    L1 stays the AOTA-B201610S3R3-101-T, the only inductor approved for the
    RP235x. JLCPCB places it through parts pre-order or Global Sourcing;
    failing that, DigiKey and hand fitting.
    Record the board pipeline to reuse from tspico-hardware (schlib.py
    sheets, gen_board/gen_layout, Freerouting via flow.py, check.sh,
    gen_fab.py) and the edge connection: v3's 2x32 gold-finger footprint,
    with fab settings and the unverified side-A-on-top assumption.
2026-10-16 Port test done: nothing answers FCh/FDh, the ports stand
    On David's 2068 (TS-Pico fitted) OUT 252/253 left the border alone, and
    IN 252/253 drift between 127 and 255 regardless of the keyboard while
    IN 254 reads it: a floating bus. Close open question 1, testing step 1
    and phase 1. Correct the absent-board note: the bus floats (D7 often
    reads 0), so detection relies on the A5h/5Ah pair, never a single FFh.
2026-10-18 Spec: r: channels, OPEN # streams on the RAM disk (phase 9)
    CHANS records with the f: hooks rather than Timex's banked channels;
    the ROM reads and writes the board directly through the mover's window;
    open-file slots and an open-stream mask for power-off, reset and NEW;
    modes, records and TAB as f:, with 2068-native text.
2026-10-19 Board: schematic and placement on the TS-Pico v3's form factor
    The KiCad project in hardware/, built with v3's script pipeline (copied
    from tspico-hardware and renamed). Four generated sheets (interface,
    SRAM, RP2350B controller, power and battery); ERC has one expected
    warning. Every part placed on v3's 130 x 56 mm body with its fingers and
    mounting holes; v3's RP2350B pre-routes carry over unchanged. Not routed.
    [interface.kicad_sch, mcu.kicad_sch, megabank-jlcpcb-bom.csv, megabank.kicad_pcb, megabank.kicad_sch, memory.kicad_sch, power.kicad_sch]
2026-10-19 Board: routed, DRC clean; render in the README
    Routed by v3's flow.py with Freerouting 2.4.1, no hand edits: 1768 track
    segments, 326 vias (all 0.6/0.3 mm), DRC clean at every severity.
    One v3 pre-route changed: v3 drops supply pin 29 into the lanes of pads
    27/28, spare there, but here they are nDOE and BE_REQ, and every attempt
    left both sealed in. The 24/29 link now runs under the package to pin 15.
    finish.py no longer crashes when its lift-and-retry backup is missing.
    The top and bottom renders are in docs/images; the README shows the top.
    [megabank-bom-full.csv, megabank.kicad_pcb]
2026-10-19 Spec: /M1 in the port decode; test the 2068's data buffers
    Gustavo's review of the hardware:
    - Port decode now requires /IORQ with /RD or /WR, and /M1 high.
    - New testing step 2: a logic analyser on U5/U9 pins 1 and 19 while
    IN/OUT to FCh/FDh run from ZEUS, since the port test cannot tell an
    enabled buffer from a floating bus.
    - Open question 15: keeping the 2068's buffers off if they do switch on.
    - Open question 16: /INT and /NMI on the board, before it is ordered.
2026-10-19 Spec: ZEUS assembles the buffer test; which analyser to use
2026-10-19 Board: /INT and /NMI for the controller (open question 16)
    - U7 SN74LVC2G34 brings /INT (A14) and /NMI (A15) to GPIO43/44.
    - U6, a second 74LVC1G06, pulls /NMI from GPIO45 (NMI_REQ), open-drain
    like /BE; R4 holds NMI_REQ low until the firmware runs.
    - Placed over fingers A14/A15 between C3 and U2. Re-routed by flow.py
    (closed on attempt 2): DRC clean, nothing unconnected; ERC has the one
    expected warning. BOMs and renders regenerated.
    - Spec: pin table (46 of 48, now counting the /BE read-back), parts,
    open question 16 marked added.
    [interface.kicad_sch, mcu.kicad_sch, megabank-bom-full.csv, megabank-jlcpcb-bom.csv, megabank.kicad_pcb]
2026-10-20 Scripts: flow.py falls back to FREEROUTING_JAR
    flow.py's --jar now defaults to $FREEROUTING_JAR, as autoroute.py's
    already did. Both expand ~ and stop before touching the board if
    the jar isn't there.
2026-10-22 Spec: bus mastering (revision 2); the TC2068 model on open question 17
    Jon's follow-up: DMA into the screen is possible through the SCLD's normal
    host path. Record what it needs (Z80-shaped cycles on CLK, /BE released,
    the free windows, short bus holds for refresh) and what the board would
    change: two-way address and control buffers, A8-A12 to the controller,
    /BUSRQ, /BUSAK and CLK. About 10 more GPIOs against 2 spare, so probably a
    second controller. Load ZX's VHDL model keys contention on A15-A14 and
    /IORQ only, so a bank in chunk 2 or 3 is probably contended.
2026-10-27 Spec: ZXDesk, and its notes kept through power-off
    - examples/: Jon's two ZXDesk builds (standard and 512-column TAPs).
    - New ZXDesk section: its memory map and ports, read from the binaries;
    it runs unchanged with the board fitted (the dead Spectrum 128 AY
    routine would hit FDh); the chunk-7 recipe for a battery-backed note
    store (detect, map page 7 of the board, format only if the header is
    missing, warn on STATUS); testing; later uses.
    - Open question 8: partly answered by ZXDesk. Allocation must work from
    the BASIC loader or the superblock, since ZXDesk never calls the ROM.
2026-10-29 Spec: what the ROM needs from SYSCON
    FOR, RESTORE and USR test SYSCON+1 for an AROS on every 2068, so the
    table at 5EEAh must stay intact all session, not only at boot. Add
    open question 17 on the TS-Pico's reserved range, which covers it.
2026-10-29 Docs: extended RAM for BASIC (exploration)
    How 2068 BASIC could use the board's RAM directly, as BASIC XE and
    BASIC 7.0 did. Stage A first (RAM disk, channels, overlays, page
    files), then EXTEND: the program text in banks, sharing the ROM's AROS
    path with the cartridges that use it (Pro/File 2068 is a BASIC AROS)
    through jump vectors in chunk 2. Records David's decisions, the
    TS-Pico and 2068-Leap constraints, and the open questions.
    Spec: open question 18 links it; question 17 notes that the TS-Pico
    firmware repo has no reservation of 5DDDh-633Fh.
2026-10-29 Spec: ZXDesk from Jon's source; a storage backend, not a heap page
    Jon's repository (jon0x0/ts2068, ZXDesk2068, read at 30c5d64) corrects
    what was read from the binaries: the heap at DF51h holds windows, not
    notes. Files go through a registry of six-vector storage backends; the
    2068 build has only RAM (four files of 256 bytes), and the Spectrum
    builds have a 128K RAM disk of eight 8K files paged in at C000h.
    - ZXDesk section rewritten from the source: mindbox77's original,
    Jon's memory layout, the storage registry, the 128K backend.
    - The recipe is now ST_MEGABANK: the 128K backend with the board's
    paging, a directory page and seven 8K files in the first bank,
    mapped one at a time int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
2026-11-07 Docs: PicoVideo on the Megabank (exploration)
    A second RP2350B on the card as video controller: DVI/HDMI out of HSTX,
    the AY and beeper as HDMI audio, and a private path to the SRAM in the
    Z80's refresh and non-board cycles, for the fast moves Jon's accelerated
    video work needs. LDO core supply on both controllers, as on OpenSpand.
    The spec's PicoVideo section links to it.
2026-11-07 Board: LDO for the RP2350B core instead of the switcher and L1
    U23, an ME6211C12M5G-N (SOT-23-5, C236672), supplies DVDD at 1.2 V, as on
    the OpenSpand card. The switcher's Abracon inductor (L1) was the scarcest
    part on the board. VREG_LX open, VREG_FB to GND, VREG_VIN and VREG_AVDD
    still powered (RP2350 datasheet 6.3.7). C40 1 uF in, C20 4.7 uF out.
    With FB grounded, pin 51 is the only DVDD pin reachable from outside the
    pad ring, so the LDO sits above it and feeds it straight down (0.3 mm);
    v3's spine under the package carries DVDD to pins 10 and 32.
    Spare GPIO46/47 go to test pads TP4/TP5 (silk GP46, GP47) for bench
    experiments. Re-routed with flow.py: closed on the first attempt; ERC on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
    [mcu.kicad_sch, megabank-bom-full.csv, megabank-jlcpcb-bom.csv, megabank.kicad_pcb]
2026-11-07 BT1 fitted by hand: Keystone 3034 from DigiKey
    The CR2032 holder alone forces JLCPCB's Standard PCBA (edge rails against
    the fingers), so BT1 is DNP at JLCPCB and out of the BOM and CPL. The
    footprint is Keystone 3034's, so the part is the 3034 itself (DigiKey
    36-3034-ND). No re-route: only the footprint's DNP flag changed.
    [megabank-bom-full.csv, megabank-jlcpcb-bom.csv, megabank.kicad_pcb, power.kicad_sch]
2026-11-07 BT1: Keystone 3034TR (C5213768), fitted by JLCPCB, as on OpenSpand
    The Q&J CR2032-BS-6-1 (C70377) is what forced Standard PCBA; the OpenSpand
    card's Keystone 3034TR, on the same footprint, went through on Economic.
    BT1 is fitted again (654 in stock); hand-fitting a DigiKey 3034 stays the
    fallback. No re-route: the footprint is unchanged.
    [megabank-bom-full.csv, megabank-jlcpcb-bom.csv, megabank.kicad_pcb, power.kicad_sch]
2026-11-07 Fab: commit the JLCPCB upload files, as on OpenSpand
    hardware/fab/jlcpcb/ now carries megabank-gerbers.zip, megabank-bom.csv
    and megabank-cpl.csv, with fab/NOTES.md, generated by gen_fab.py from the
    current board. The unzipped Gerbers and the router's scratch folder
    (fab/route/) stay ignored.
    [megabank-bom.csv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]
